Alwwex/Cyklopo-ta-/docs/img/displej-dash-noc.png

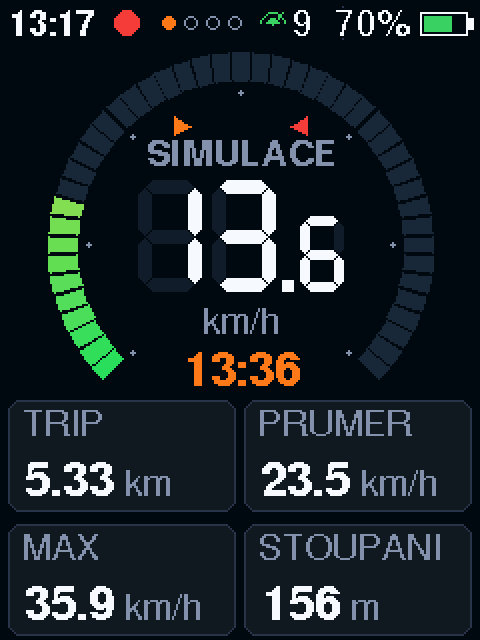
docs/img/displej-dash-noc.png
