Alwwex/Cyklopo-ta-/docs/img/displej-dash-retro.png

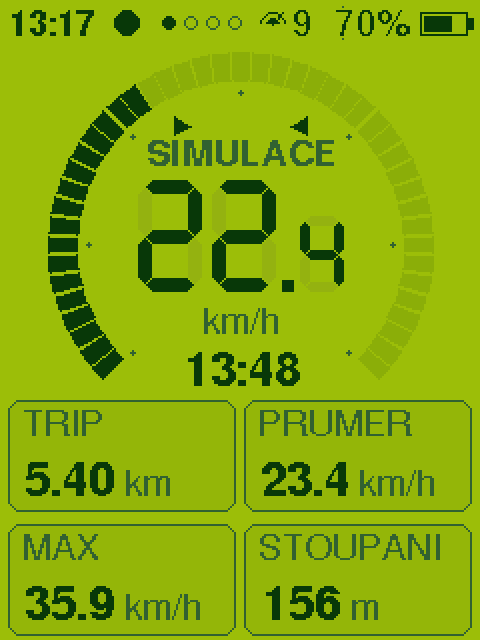
docs/img/displej-dash-retro.png
