Alwwex/Cyklopo-ta-/docs/img/displej-mapa-retro.png

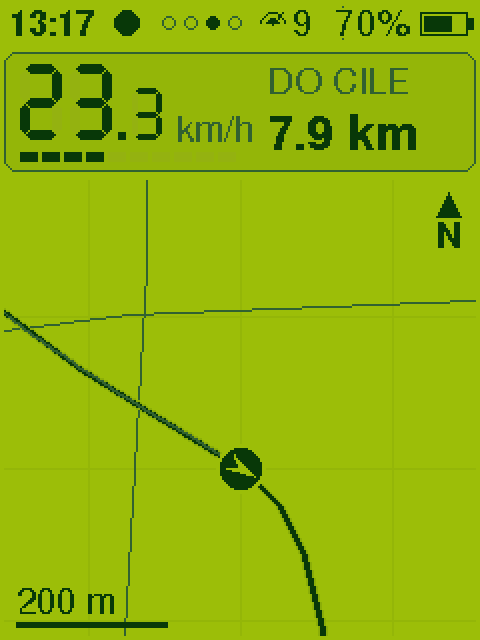
docs/img/displej-mapa-retro.png
