Alwwex/Cyklopo-ta-/docs/img/displej-souhrn.png

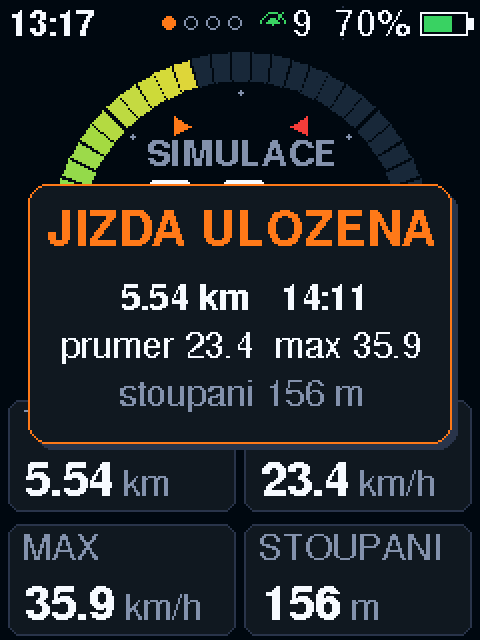
docs/img/displej-souhrn.png
