Alwwex/Cyklopo-ta-/hardware/enclosure/img/base_top.png

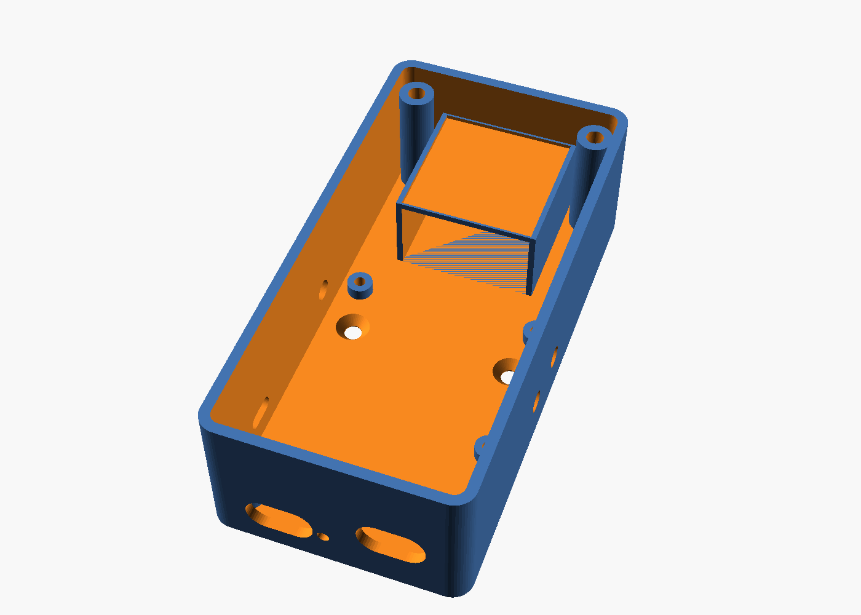
hardware/enclosure/img/base_top.png
