Alwwex/Cyklopo-ta-/hardware/enclosure/img/exploded.png

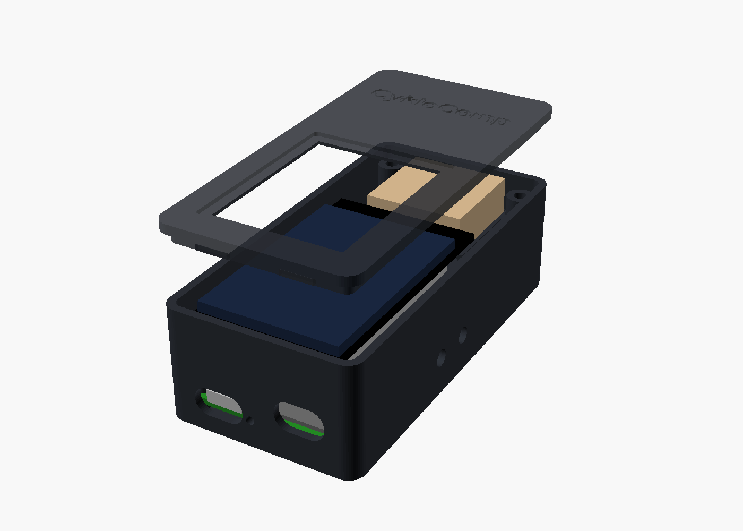
hardware/enclosure/img/exploded.png
