Alwwex/Cyklopo-ta-/hardware/enclosure/stl/lid.stl

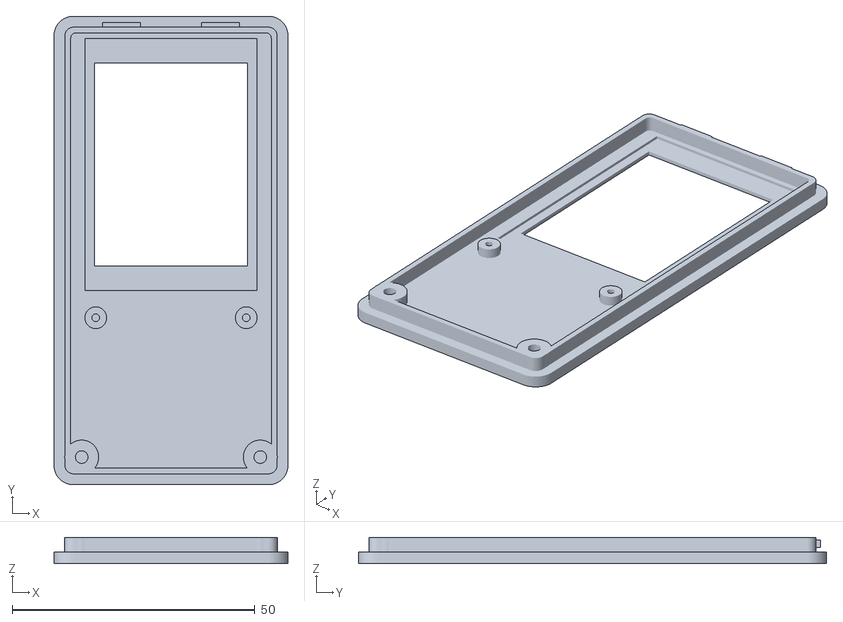
[picture p11: CAD file, 2026-10-15]
hardware/enclosure/stl/lid.stl
48.2 x 96.5 x 5.40
