Alwwex/Cyklopo-ta-/hardware/pcb/build_rucni/CykloPCB_v1_rucni.step

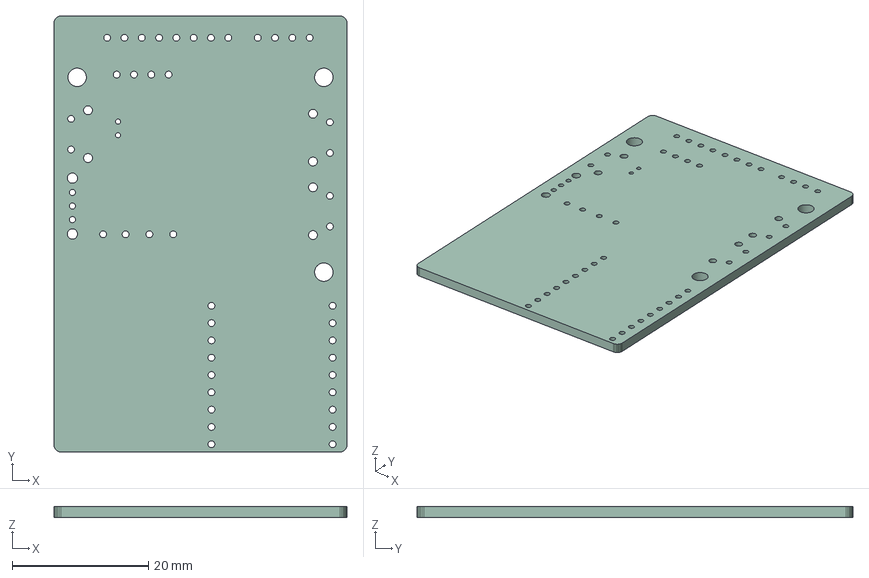
[picture p12: CAD file, 2026-10-15]
hardware/pcb/build_rucni/CykloPCB_v1_rucni.step
43.0 x 64.0 x 1.60 mm
