Alwwex/Cyklopo-ta-/hardware/enclosure/stl/tray.stl

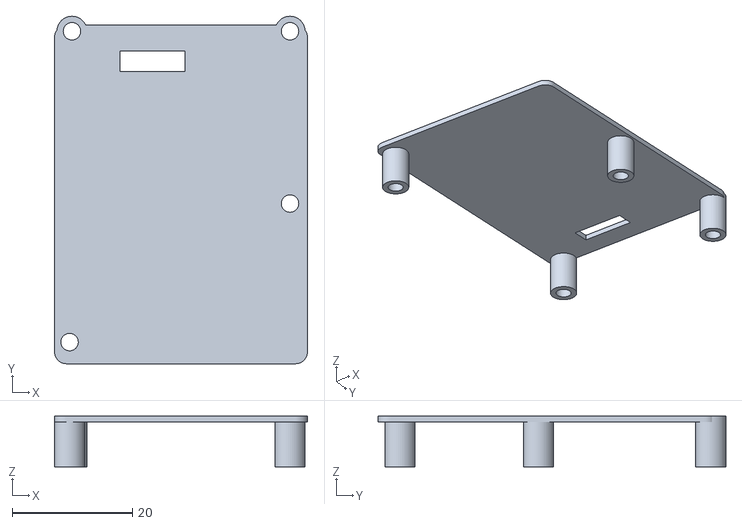
[picture p13: CAD file, 2026-10-15]
hardware/enclosure/stl/tray.stl
42.0 x 57.7 x 8.40
