Alwwex/Cyklopo-ta-/hardware/enclosure/stl/garmin_test.stl

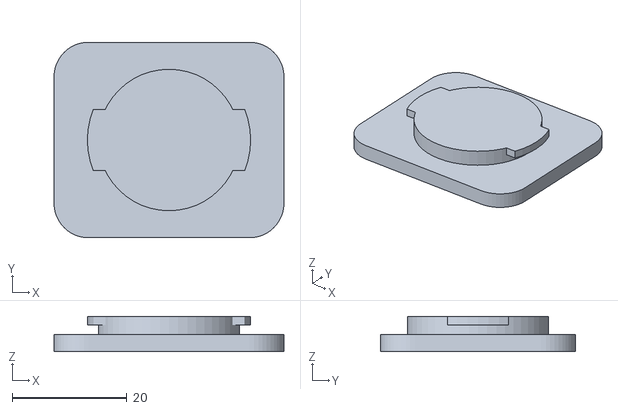
[picture p14: CAD file, 2026-10-15]
hardware/enclosure/stl/garmin_test.stl
40.0 x 34.0 x 6.10
