Alwwex/Cyklopo-ta-/hardware/enclosure/stl/base.stl

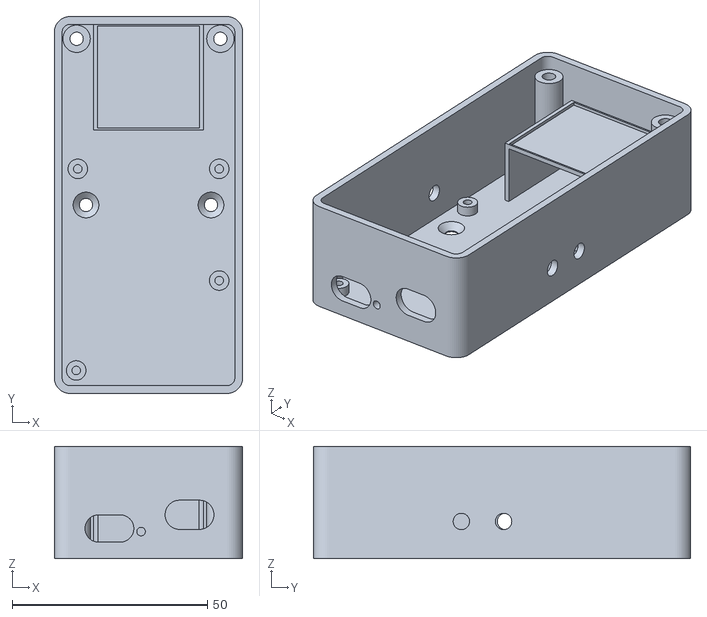
[picture p15: CAD file, 2026-10-15]
hardware/enclosure/stl/base.stl
48.2 x 96.5 x 28.7
