Alwwex/Cyklopo-ta-/hardware/pcb/generate_pcb.py

#!/usr/bin/env python3
"""
CykloPCB v1 - nosna deska pro CykloComp (ESP32-C3-Zero + displej + GPS + Li-Po).

Tento skript je "zdrojak" plosneho spoje: z popisu soucastek a spoju nize
vytvori KiCad desku, rozmisti soucastky, nechá cesty natahnout autorouterem
Freerouting, prida rozliti zeme, zkontroluje DRC a vyexportuje podklady
pro vyrobu u JLCPCB (Gerber + vrtani + BOM + CPL pro osazeni).

Pozadavky (Linux):  KiCad 7 (python modul pcbnew + kicad-cli), Java 17+,
                    freerouting-1.9.0.jar, xvfb-run
Spusteni:           python3 generate_pcb.py  [--freerouting /cesta/freerouting.jar]
"""
import argparse
import csv
import math
import os
import re
import shutil
import subprocess
import sys
import zipfile

import pcbnew

HERE = os.path.dirname(os.path.abspath(__file__))
FP_LIB = '/usr/share/kicad/footprints'
NAME = 'CykloPCB_v1'

W, H = 43.0, 64.0          # rozmer desky [mm]
VIA_D, VIA_DRILL = 0.7, 0.3
USB_SLOT_W = 0.7
SILK_W = 0.16
SILK_HOLE_CLR = 0.25
SILK_PAD_CLR = 0.2
SILK_MIN_SEG = 0.20
SILK_EDGE_CLR = 0.2        # potisk konci aspon 0.2 mm od hrany desky
CORNER = 1.0               # zaobleni rohu

mm = pcbnew.FromMM

# ---------------------------------------------------------------------------
# NAPAJENI (cela cesta):
#   USB-C (J1) --VBUS--> TP4056 (U1, nabijeni 600 mA) --BAT+--> Li-Po (J4)
#   VBUS --D3 Schottky--> SYS ;  BAT+ --Q1 P-MOSFET--> SYS   ("load sharing":
#   pri pripojenem USB jede system z USB a baterie se jen nabiji, jinak z baterie)
#   SYS --SW1 vypinac--> VSW --U2 LDO 3.3 V--> 3V3 (ESP, displej, GPS)
#   VSW --R7/R8 delic 1:2--> GPIO0 (mereni baterie / detekce USB)
#   3V3 --Q2--> GPS_VCC (GPIO10 vypina GPS ve spanku)
#   3V3 --Q3--> BLK displeje (GPIO7 = PWM jas)
# Baterie MUSI mit vlastni ochranny obvod (PCM) - u clanku 103450 standard.
# ---------------------------------------------------------------------------

# LCSC cisla pro osazeni u JLCPCB (pred objednavkou zkontroluj skladem)
LCSC = {
    'TP4056': 'C16581', 'AO3401A': 'C15127', 'SS34': 'C8678', 'AP2112K-3.3': 'C51118',
    'USB-C 16P': 'C165948', '10uF': 'C15850', '100nF': 'C14663', '5.1k': 'C23186',
    '2k': 'C22975', '1k': 'C21190', '100k': 'C25803', '10k': 'C25804',
    'LED red': 'C2286', 'LED green': 'C7429914',
}

R0603 = ('Resistor_SMD', 'R_0603_1608Metric')
C0603 = ('Capacitor_SMD', 'C_0603_1608Metric')
C0805 = ('Capacitor_SMD', 'C_0805_2012Metric')
LED0603 = ('LED_SMD', 'LED_0603_1608Metric')
SOT23 = ('Package_TO_SOT_SMD', 'SOT-23')

# (ref, (lib, footprint) | 'C3ZERO', value, x, y, rot, {pad: net}, osazuje JLC)
PARTS = [
    # --- USB-C nabijeni ---
    ('J1', ('Connector_USB', 'USB_C_Receptacle_HRO_TYPE-C-31-M-12'), 'USB-C 16P', 11.5, 60.65, 0,
     {'A1': 'GND', 'B1': 'GND', 'A12': 'GND', 'B12': 'GND', 'S1': 'GND',
      'A4': 'VBUS', 'B4': 'VBUS', 'A9': 'VBUS', 'B9': 'VBUS', 'A5': 'CC1', 'B5': 'CC2'}, True),
    ('R1', R0603, '5.1k', 8.0, 52.6, 90, {'1': 'CC1', '2': 'GND'}, True),
    ('R2', R0603, '5.1k', 15.6, 52.6, 90, {'1': 'CC2', '2': 'GND'}, True),
    ('C1', C0805, '10uF', 18.6, 50.6, 90, {'1': 'VBUS', '2': 'GND'}, True),
    # --- nabijecka TP4056 ---
    ('U1', ('Package_SO', 'SOIC-8-1EP_3.9x4.9mm_P1.27mm_EP2.41x3.3mm'), 'TP4056', 12.0, 46.6, 0,
     {'1': 'GND', '2': 'PROG', '3': 'GND', '4': 'VBUS', '5': 'BAT+', '6': 'STDBY', '7': 'CHRG', '8': 'VBUS', '9': 'GND'}, True),
    ('R3', R0603, '2k', 7.3, 43.0, 0, {'1': 'PROG', '2': 'GND'}, True),
    ('C2', C0805, '10uF', 12.0, 41.4, 0, {'1': 'BAT+', '2': 'GND'}, True),
    ('R4', R0603, '1k', 18.5, 54.2, 0, {'1': 'VBUS', '2': 'LED_R'}, True),
    ('R5', R0603, '1k', 18.5, 56.0, 0, {'1': 'VBUS', '2': 'LED_G'}, True),
    ('D1', LED0603, 'LED red', 18.5, 58.0, 180, {'1': 'CHRG', '2': 'LED_R'}, True),
    ('D2', LED0603, 'LED green', 18.5, 60.0, 180, {'1': 'STDBY', '2': 'LED_G'}, True),
    # --- load sharing + vypinac + LDO ---
    ('D3', ('Diode_SMD', 'D_SMA'), 'SS34', 12.6, 37.6, 0, {'1': 'SYS', '2': 'VBUS'}, True),
    ('Q1', SOT23, 'AO3401A', 18.3, 38.6, 0, {'1': 'VBUS', '2': 'SYS', '3': 'BAT+'}, True),
    ('R6', R0603, '100k', 18.3, 42.2, 0, {'1': 'VBUS', '2': 'GND'}, True),
    ('C3', C0805, '10uF', 18.3, 35.4, 0, {'1': 'SYS', '2': 'GND'}, True),
    ('SW1', ('Button_Switch_THT', 'SW_Slide_SPDT_Angled_CK_OS102011MA1Q'), 'ON/OFF', 2.7, 45.0, -90,
     {'1': 'SYS', '2': 'VSW', '3': ''}, False),
    ('U2', ('Package_TO_SOT_SMD', 'SOT-23-5'), 'AP2112K-3.3', 9.6, 31.6, 0,
     {'1': 'VSW', '2': 'GND', '3': 'VSW', '4': '', '5': '3V3'}, True),
    ('C4', C0805, '10uF', 5.0, 30.0, 90, {'1': 'VSW', '2': 'GND'}, True),
    ('C6', C0805, '10uF', 14.4, 31.6, 90, {'1': '3V3', '2': 'GND'}, True),
    ('C7', C0603, '100nF', 14.4, 28.2, 0, {'1': '3V3', '2': 'GND'}, True),
    # --- mereni baterie (delic 1:2 -> GPIO0) ---
    ('R7', R0603, '100k', 26.0, 38.4, 0, {'1': 'VSW', '2': 'BAT_SENSE'}, True),
    ('R8', R0603, '100k', 26.0, 36.6, 0, {'1': 'BAT_SENSE', '2': 'GND'}, True),
    ('C5', C0603, '100nF', 26.0, 34.8, 0, {'1': 'BAT_SENSE', '2': 'GND'}, True),
    # --- baterie ---
    ('J4', ('Connector_JST', 'JST_PH_S2B-PH-K_1x02_P2.00mm_Horizontal'), 'LiPo 3.7V', 9.0, 22.6, 90,
     {'1': 'BAT+', '2': 'GND'}, False),
    # --- ESP32-C3-Zero ---
    ('U3', 'C3ZERO', 'ESP32-C3-Zero', 32.0, 52.7, 180,
     {'1': '', '2': 'GND', '3': '3V3', '4': 'BAT_SENSE', '5': 'TFT_RST', '6': 'TFT_DC', '7': 'TFT_CS',
      '8': 'TFT_SCLK', '9': 'BTN1', '10': 'TFT_MOSI', '11': 'BL_PWM', '12': 'BTN2', '13': 'BTN3',
      '14': 'GPS_EN', '15': '', '16': '', '17': 'GPS_TXD', '18': 'GPS_RXD'}, False),
    # --- displej (ST7789, poradi pinu jako bezny 2.0"/2.4"/2.8" IPS modul) ---
    ('J2', ('Connector_PinHeader_2.54mm', 'PinHeader_1x08_P2.54mm_Vertical'), 'TFT', 7.8, 3.2, 90,
     {'1': 'GND', '2': '3V3', '3': 'TFT_SCLK', '4': 'TFT_MOSI', '5': 'TFT_RST', '6': 'TFT_DC', '7': 'TFT_CS', '8': 'TFT_BLK'}, False),
    ('Q3', SOT23, 'AO3401A', 22.0, 9.6, 90, {'1': 'BL_G', '2': '3V3', '3': 'TFT_BLK'}, True),
    ('R11', R0603, '100k', 25.2, 9.0, 90, {'1': '3V3', '2': 'BL_G'}, True),
    ('R12', R0603, '1k', 25.2, 12.6, 90, {'1': 'BL_G', '2': 'BL_PWM'}, True),
    # --- GPS ---
    ('J3', ('Connector_PinHeader_2.54mm', 'PinHeader_1x04_P2.54mm_Vertical'), 'GPS', 29.9, 3.2, 90,
     {'1': 'GPS_VCC', '2': 'GND', '3': 'GPS_TXD', '4': 'GPS_RXD'}, False),
    ('Q2', SOT23, 'AO3401A', 30.4, 9.6, 90, {'1': 'GPS_G', '2': '3V3', '3': 'GPS_VCC'}, True),
    ('R9', R0603, '100k', 33.6, 9.0, 90, {'1': '3V3', '2': 'GPS_G'}, True),
    ('R10', R0603, '1k', 33.6, 12.6, 90, {'1': 'GPS_G', '2': 'GPS_EN'}, True),
    ('C8', C0603, '100nF', 27.6, 9.0, 90, {'1': 'GPS_VCC', '2': 'GND'}, True),
    # --- tlacitka (boční, uhlova) + konektor pro externi vodotesna tlacitka ---
    ('SW2', ('Button_Switch_THT', 'SW_Tactile_SPST_Angled_PTS645Vx31-2LFS'), 'MODE', 2.5, 19.6, 90,
     {'1': 'BTN1', '2': 'GND'}, False),
    ('SW3', ('Button_Switch_THT', 'SW_Tactile_SPST_Angled_PTS645Vx31-2LFS'), 'START', 40.5, 15.6, -90,
     {'1': 'BTN2', '2': 'GND'}, False),
    ('SW4', ('Button_Switch_THT', 'SW_Tactile_SPST_Angled_PTS645Vx31-2LFS'), 'PAUSE', 40.5, 26.4, -90,
     {'1': 'BTN3', '2': 'GND'}, False),
    ('R13', R0603, '100k', 19.0, 23.0, 0, {'1': '3V3', '2': 'BTN1'}, True),
    ('R14', R0603, '10k', 30.0, 21.0, 0, {'1': '3V3', '2': 'BTN2'}, True),
    ('J5', ('Connector_PinHeader_2.54mm', 'PinHeader_1x04_P2.54mm_Vertical'), 'BTN ext', 13.0, 14.0, 90,
     {'1': 'BTN1', '2': 'BTN2', '3': 'BTN3', '4': 'GND'}, False),
    # --- montazni otvory M2.5 ---
    ('H1', ('MountingHole', 'MountingHole_2.7mm_M2.5'), 'M2.5', 3.4, 9.0, 0, {}, False),
    ('H2', ('MountingHole', 'MountingHole_2.7mm_M2.5'), 'M2.5', 39.6, 9.0, 0, {}, False),
    ('H3', ('MountingHole', 'MountingHole_2.7mm_M2.5'), 'M2.5', 3.0, 60.6, 0, {}, False),
    ('H4', ('MountingHole', 'MountingHole_2.7mm_M2.5'), 'M2.5', 39.6, 37.6, 0, {}, False),
]

POWER_NETS = ['GND', 'VBUS', 'BAT+', 'BNEG', 'SYS', 'VSW', '3V3', 'GPS_VCC', 'TFT_BLK']

# popisky pinu ESP32-C3-Zero (pady 1-9 vlevo od USB dolu, 10-18 vpravo zdola nahoru, USB nahore)
C3_LABELS = ['5V', 'GND', '3V3', 'GP0', 'GP1', 'GP2', 'GP3', 'GP4', 'GP5',
             'GP6', 'GP7', 'GP8', 'GP9', 'GP10', 'GP18', 'GP19', 'GP20', 'GP21']

SILK = [  # (text, x, y, size, rot)
    ('CykloPCB v1', 21.5, 27.4, 1.2, 0),
    ('CykloComp', 21.5, 29.4, 0.9, 0),
    ('TFT', 3.6, 3.2, 1.0, 0),
    ('GPS', 27.75, 3.2, 0.8, 90),
    ('+', 7.3, 22.6, 0.9, 0),
    ('-', 7.3, 20.25, 0.9, 0),
    ('ON', 5.2, 40.6, 1.0, 0),
    ('MODE', 3.4, 25.0, 0.8, 0),
    ('START', 36.2, 12.0, 0.8, 0),
    ('PAUZA', 34.5, 23.4, 0.8, 0),
    ('NABIJENI', 11.5, 50.3, 0.8, 0),
    ('ESP USB', 32.0, 39.6, 0.8, 0),
]
# popisky pinu konektoru (pod kazdym pinem)
for i, t in enumerate(['G', 'V', 'CK', 'DA', 'RS', 'DC', 'CS', 'BL']):
    SILK.append((t, 7.8 + i * 2.54, 5.6, 0.8, 0))
for i, t in enumerate(['V', 'G', 'TX', 'RX']):
    SILK.append((t, 29.9 + i * 2.54, 5.6, 0.8, 0))
for i, t in enumerate(['M', 'S', 'P', 'G']):
    SILK.append((t, 13.0 + i * 2.54, 16.7, 0.8, 0))


# ===========================================================================
# VARIANTA "RUCNI" (--variant hand): objednas jen holy plosny spoj a vse
# zapajis sam. Vetsi soucastky (1206, SOT-223, SMA, THT) a misto USB-C + TP4056
# na desce se pouzije hotovy modul "TP4056 Type-C" s ochranou (DW01 + 8205A).
# Modul se nalepi oboustrannou penovou paskou (~1 mm) na desku, USB-C k zadni
# hrane, a 4 dratky vedou z jeho plosek na radu plosek za jeho koncem:
#   modul IN+  -> IN+  (VBUS: D3 load sharing, gate Q1, detekce USB)
#   modul OUT+ -> OUT+ (BAT+; na modulu je OUT+ = B+)
#   modul B-   -> B-   (BNEG: minus baterie z J4 - NIKDY ne primo na GND,
#                       jinak se obejde ochrana modulu)
#   modul OUT- -> OUT- (GND)        modul IN- se nezapojuje
# Modul bez ochrany (jen IN+/IN-/B+/B-): IN+ -> IN+, B+ -> OUT+, B- -> OUT-
# a propojit pajeci mustek JP1 (B- = GND).
# Zbytek zapojeni (vypinac, LDO, mereni baterie, spinani GPS a podsviceni,
# tlacitka, ESP) je stejny jako ve variante pro JLC -> stejny firmware (BOARD_PROFILE 1).
# ===========================================================================
NAME_HAND = 'CykloPCB_v1_rucni'
R1206 = ('Resistor_SMD', 'R_1206_3216Metric_Pad1.30x1.75mm_HandSolder')
C1206 = ('Capacitor_SMD', 'C_1206_3216Metric_Pad1.33x1.80mm_HandSolder')
SOT23H = ('Package_TO_SOT_SMD', 'SOT-23_Handsoldering')
SMAH = ('Diode_SMD', 'D_SMA_Handsoldering')
LDO_FP = ('Package_TO_SOT_SMD', 'SOT-223-3_TabPin2')
LDO_PART = 'MCP1825S-3302E/DB'
LDO_PINS = {'1': 'VSW', '2': 'GND', '3': '3V3'}          # SOT-223: 1 VIN, 2 GND (+ chladici plocha), 3 VOUT

# misto pro modul TP4056 Type-C (sirka x delka od hrany desky): pokryje bezne moduly
# 25-28.4 x 17.2-17.8 mm + presah USB-C 1-1.4 mm + vule na nalepeni
# (strana "+" modulu = IN+/B+/OUT+ je pri pohledu shora s USB-C dole VLEVO)
MOD_W, MOD_L = 19.0, 30.3
MOD_PAD_D, MOD_PAD_DRILL = 2.2, 1.0
MOD_PADS = [  # (cislo, x, y, popisek, sit) od stredu mista pro modul; rada plosek za jeho koncem
    ('1', -4.3, -MOD_L / 2 - 1.65, 'IN+', 'VBUS'),
    ('2', -1.0, -MOD_L / 2 - 1.65, 'OUT+', 'BAT+'),
    ('3', 2.5, -MOD_L / 2 - 1.65, 'B-', 'BNEG'),
    ('4', 6.0, -MOD_L / 2 - 1.65, 'OUT-', 'GND'),
]

PARTS_HAND = [
    # --- nabijeci modul TP4056 Type-C (uz ho mas) ---
    ('A1', 'TP4056MOD', 'TP4056 USB-C modul', 11.5, H - MOD_L / 2, 0, {m[0]: m[4] for m in MOD_PADS}, False),
    ('J4', ('Connector_JST', 'JST_PH_S2B-PH-K_1x02_P2.00mm_Horizontal'), 'LiPo 3.7V', 9.4, 17.5, 90,
     {'1': 'BAT+', '2': 'BNEG'}, False),
    ('JP1', ('Jumper', 'SolderJumper-2_P1.3mm_Open_Pad1.0x1.5mm'), 'B- = GND', 20.7, 32.0, 90,
     {'1': 'BNEG', '2': 'GND'}, False),
    # --- load sharing + vypinac + LDO ---
    ('D3', SMAH, 'SS34', 11.9, 22.2, 0, {'1': 'SYS', '2': 'VBUS'}, False),
    ('Q1', SOT23H, 'AO3401A', 19.6, 22.2, 0, {'1': 'VBUS', '2': 'SYS', '3': 'BAT+'}, False),
    ('R6', R1206, '100k', 10.5, 26.65, 0, {'1': 'VBUS', '2': 'GND'}, False),
    ('C3', C1206, '10uF', 16.0, 26.65, 0, {'1': 'SYS', '2': 'GND'}, False),
    ('SW1', ('Button_Switch_THT', 'SW_Slide_SPDT_Angled_CK_OS102011MA1Q'), 'ON/OFF', 2.7, 25.9, -90,
     {'1': 'SYS', '2': 'VSW', '3': ''}, False),
    ('U2', LDO_FP, LDO_PART, 27.5, 23.9, 0, LDO_PINS, False),
    ('C4', C1206, '10uF', 25.0, 18.3, 0, {'1': 'VSW', '2': 'GND'}, False),
    ('C6', C1206, '10uF', 25.0, 29.4, 0, {'1': '3V3', '2': 'GND'}, False),
    ('C7', C1206, '100nF', 30.6, 29.4, 0, {'1': '3V3', '2': 'GND'}, False),
    # --- mereni baterie (delic 1:2 -> GPIO0) ---
    ('R7', R1206, '100k', 25.0, 32.9, 0, {'1': 'VSW', '2': 'BAT_SENSE'}, False),
    ('R8', R1206, '100k', 25.0, 35.9, 0, {'1': 'BAT_SENSE', '2': 'GND'}, False),
    ('C5', C1206, '100nF', 30.0, 34.4, 90, {'1': 'BAT_SENSE', '2': 'GND'}, False),
    # --- ESP32-C3-Zero ---
    ('U3', 'C3ZERO', 'ESP32-C3-Zero', 32.0, 52.7, 180,
     {'1': '', '2': 'GND', '3': '3V3', '4': 'BAT_SENSE', '5': 'TFT_RST', '6': 'TFT_DC', '7': 'TFT_CS',
      '8': 'TFT_SCLK', '9': 'BTN1', '10': 'TFT_MOSI', '11': 'BL_PWM', '12': 'BTN2', '13': 'BTN3',
      '14': 'GPS_EN', '15': '', '16': '', '17': 'GPS_TXD', '18': 'GPS_RXD'}, False),
    # --- displej ---
    ('J2', ('Connector_PinHeader_2.54mm', 'PinHeader_1x08_P2.54mm_Vertical'), 'TFT', 7.8, 3.2, 90,
     {'1': 'GND', '2': '3V3', '3': 'TFT_SCLK', '4': 'TFT_MOSI', '5': 'TFT_RST', '6': 'TFT_DC', '7': 'TFT_CS', '8': 'TFT_BLK'}, False),
    ('Q3', SOT23H, 'AO3401A', 21.4, 9.2, 90, {'1': 'BL_G', '2': '3V3', '3': 'TFT_BLK'}, False),
    ('R11', R1206, '100k', 25.0, 9.2, 90, {'1': '3V3', '2': 'BL_G'}, False),
    ('R12', R1206, '1k', 28.0, 9.2, 90, {'1': 'BL_G', '2': 'BL_PWM'}, False),
    # --- GPS ---
    ('J3', ('Connector_PinHeader_2.54mm', 'PinHeader_1x04_P2.54mm_Vertical'), 'GPS', 29.9, 3.2, 90,
     {'1': 'GPS_VCC', '2': 'GND', '3': 'GPS_TXD', '4': 'GPS_RXD'}, False),
    ('Q2', SOT23H, 'AO3401A', 31.6, 9.2, 90, {'1': 'GPS_G', '2': '3V3', '3': 'GPS_VCC'}, False),
    ('R9', R1206, '100k', 25.0, 15.1, 0, {'1': '3V3', '2': 'GPS_G'}, False),
    ('R10', R1206, '1k', 30.5, 15.1, 0, {'1': 'GPS_G', '2': 'GPS_EN'}, False),
    ('C8', C1206, '100nF', 35.0, 9.2, 90, {'1': 'GPS_VCC', '2': 'GND'}, False),
    # --- tlacitka ---
    ('SW2', ('Button_Switch_THT', 'SW_Tactile_SPST_Angled_PTS645Vx31-2LFS'), 'MODE', 2.5, 19.6, 90,
     {'1': 'BTN1', '2': 'GND'}, False),
    ('SW3', ('Button_Switch_THT', 'SW_Tactile_SPST_Angled_PTS645Vx31-2LFS'), 'START', 40.5, 15.6, -90,
     {'1': 'BTN2', '2': 'GND'}, False),
    ('SW4', ('Button_Switch_THT', 'SW_Tactile_SPST_Angled_PTS645Vx31-2LFS'), 'PAUSE', 40.5, 26.4, -90,
     {'1': 'BTN3', '2': 'GND'}, False),
    ('R13', R1206, '100k', 18.0, 16.0, 90, {'1': '3V3', '2': 'BTN1'}, False),
    ('R14', R1206, '10k', 30.5, 18.3, 0, {'1': '3V3', '2': 'BTN2'}, False),
    ('J5', ('Connector_PinHeader_2.54mm', 'PinHeader_1x04_P2.54mm_Vertical'), 'BTN ext', 9.2, 8.6, 90,
     {'1': 'BTN1', '2': 'BTN2', '3': 'BTN3', '4': 'GND'}, False),
    # --- montazni otvory M2.5 (H3 vlevo dole odpada - je tam modul) ---
    ('H1', ('MountingHole', 'MountingHole_2.7mm_M2.5'), 'M2.5', 3.4, 9.0, 0, {}, False),
    ('H2', ('MountingHole', 'MountingHole_2.7mm_M2.5'), 'M2.5', 39.6, 9.0, 0, {}, False),
    ('H4', ('MountingHole', 'MountingHole_2.7mm_M2.5'), 'M2.5', 39.6, 37.6, 0, {}, False),
]

SILK_HAND = [
    ('CykloPCB v1 R', 11.5, 61.6, 1.0, 0),
    ('TFT', 3.6, 3.2, 1.0, 0),
    ('GPS', 27.6, 2.8, 0.8, 90),
    ('ON', 6.4, 24.4, 0.8, 90),
    ('K', 6.5, 22.2, 0.8, 0),
    ('MODE', 6.6, 12.4, 0.8, 0),
    ('START', 36.2, 12.0, 0.8, 0),
    ('PAUZA', 33.8, 32.4, 0.8, 0),
    ('USB-C ESP', 32.0, 62.4, 0.8, 0),
    ('+', 7.9, 17.5, 0.9, 0),
    ('B-', 7.5, 15.5, 0.8, 0),
]
for i, t in enumerate(['G', 'V', 'CK', 'DA', 'RS', 'DC', 'CS', 'BL']):
    SILK_HAND.append((t, 7.8 + i * 2.54, 5.6, 0.8, 0))
for i, t in enumerate(['V', 'G', 'TX', 'RX']):
    SILK_HAND.append((t, 29.9 + i * 2.54, 5.6, 0.8, 0))
for i, t in enumerate(['M', 'S', 'P', 'G']):
    SILK_HAND.append((t, 9.2 + i * 2.54, 11.3, 0.8, 0))

# popisky soucastek (R7, C3...) na potisku: {ref: (x, y, rot)}; ktere tu nejsou, umisti se samy
REF_POS_HAND = {'C8': (36.7, 9.2, 90), 'C7': (34.6, 29.4, 0), 'D3': (11.9, 24.6, 0),
                'R6': (10.5, 28.45, 0), 'C3': (16.0, 28.45, 0), 'Q1': (19.6, 19.7, 0), 'JP1': (21.0, 29.6, 0),
                'C6': (25.0, 31.15, 0), 'C5': (30.0, 37.6, 0)}
REF_SIZE_HAND = 0.8
REF_MISSING = []

# seznam soucastek k nakupu: sjednoceni nazvu + kde koupit (kody over pred objednavkou)
BOM_VALUE_HAND = {
    'MODE': 'Tlacitko 6x6 uhlove', 'START': 'Tlacitko 6x6 uhlove', 'PAUSE': 'Tlacitko 6x6 uhlove',
    'TFT': 'Kolikova lista 1x8', 'GPS': 'Kolikova lista 1x4', 'BTN ext': 'Kolikova lista 1x4 (volitelne)',
}
SHOP_HAND = {
    'TP4056 USB-C modul': 'uz mas; nejlepe verze s ochranou (6 plosek IN+ IN- B+ B- OUT+ OUT-), max. 19 x 30 mm vc. USB-C',
    'LiPo 3.7V': 'JST PH 2.0 mm 2pin uhlovy (S2B-PH-K-S) + protikus PHR-2 nebo hotovy kabel PH2.0; lze i bez nej',
    'B- = GND': 'nic nekupovat - pajeci mustek, spojit JEN pro modul bez ochrany',
    'SS34': 'Schottky 40 V 3 A v pouzdru SMA, napr. SK34A (TME: SK34A-LTP); jde i SS24A (SMA). SS34 v SMB/SMC je vetsi!',
    'AO3401A': 'P-MOSFET SOT-23, TME: AO3401A; nahrada IRLML6401 (stejne vyvody G-S-D). Kup 2-3 navic',
    'MCP1825S-3302E/DB': 'LDO 3.3 V 500 mA SOT-223 (TME, Mouser). NE AMS1117/LD1117 - maji jine poradi vyvodu!',
    '100k': 'rezistor 1206 1 % (napr. Yageo RC1206FR-07100KL) nebo sada 1206',
    '10k': 'rezistor 1206 1 % (napr. Yageo RC1206FR-0710KL)',
    '1k': 'rezistor 1206 1 % (napr. Yageo RC1206FR-071KL)',
    '10uF': 'keramicky kondenzator 1206 10 uF 25 V X5R/X7R (napr. Samsung CL31A106KAHNNNE)',
    '100nF': 'keramicky kondenzator 1206 100 nF 50 V X7R (napr. Samsung CL31B104KBCNNNC)',
    'ON/OFF': 'posuvny prepinac uhlovy C&K OS102011MA1QN1 (TME)',
    'Tlacitko 6x6 uhlove': 'C&K PTS645VL31-2 LFS (TME: PTS645VL312LFS); levna z AliExpressu mivaji jinou roztec',
    'ESP32-C3-Zero': 'uz mas (+ 2x lista 1x9, pokud nebyla pripajena)',
    'Kolikova lista 1x8': 'lista 1x40 2,54 mm (GME, TME) - nalamat; nebo zdirkova, kdyz ma jit displej odpojit',
    'Kolikova lista 1x4': 'ze stejne listy 1x40',
    'Kolikova lista 1x4 (volitelne)': 'jen pro externi vodotesna tlacitka',
}

VARIANT = 'jlc'


# ---------------------------------------------------------------------------
def load_fp(lib, name):
    fp = pcbnew.FootprintLoad(f'{FP_LIB}/{lib}.pretty', name)
    if fp is None:
        sys.exit(f'Footprint {lib}:{name} nenalezen')
    return fp


def make_c3zero(board):
    """Waveshare ESP32-C3-Zero (18 x 23.5 mm). Pady 2.54 mm, rady +-8.89 mm.
    Pady jsou protazene (2.6 mm), takze jde modul zapajet pres kolíkovou listu
    i naplocho za "castellated" pulotvory na okraji."""
    fp = pcbnew.FOOTPRINT(board)
    fp.SetFPID(pcbnew.LIB_ID('CykloPCB', 'ESP32-C3-Zero'))
    for i in range(18):
        if i < 9:
            x, y = -8.89, -10.16 + i * 2.54
        else:
            x, y = 8.89, 10.16 - (i - 9) * 2.54
        p = pcbnew.PAD(fp)
        p.SetNumber(str(i + 1))
        p.SetAttribute(pcbnew.PAD_ATTRIB_PTH)
        p.SetShape(pcbnew.PAD_SHAPE_RECT if i == 0 else pcbnew.PAD_SHAPE_OVAL)
        p.SetSize(pcbnew.VECTOR2I(mm(2.6), mm(1.6)))
        p.SetDrillSize(pcbnew.VECTOR2I(mm(1.0), mm(1.0)))
        p.SetLayerSet(p.PTHMask())
        fp.Add(p)
        p.SetPos0(pcbnew.VECTOR2I(mm(x), mm(y)))
        p.SetPosition(pcbnew.VECTOR2I(mm(x), mm(y)))
        t = pcbnew.FP_TEXT(fp)
        t.SetText(C3_LABELS[i])
        t.SetLayer(pcbnew.F_SilkS)
        t.SetTextSize(pcbnew.VECTOR2I(mm(0.8), mm(0.8)))
        t.SetTextThickness(mm(SILK_W))
        t.SetPosition(pcbnew.VECTOR2I(mm(x + (3.1 if i < 9 else -3.1)), mm(y)))
        fp.Add(t)
    # obrys modulu + USB
    def line(layer, x1, y1, x2, y2, w=0.12):
        s = pcbnew.FP_SHAPE(fp)
        s.SetShape(pcbnew.SHAPE_T_SEGMENT)
        s.SetLayer(layer)
        fp.Add(s)
        s.SetStart0(pcbnew.VECTOR2I(mm(x1), mm(y1)))
        s.SetEnd0(pcbnew.VECTOR2I(mm(x2), mm(y2)))
        s.SetDrawCoord()
        s.SetWidth(mm(w))
    for layer, d in ((pcbnew.F_Fab, 0), (pcbnew.F_CrtYd, 0.25)):
        x0, y0, x1, y1 = -9 - d, -11.75 - d, 9 + d, 11.75 + d
        line(layer, x0, y0, x1, y0, 0.05); line(layer, x1, y0, x1, y1, 0.05)
        line(layer, x1, y1, x0, y1, 0.05); line(layer, x0, y1, x0, y0, 0.05)
    return fp


def make_tp4056_module(board):
    """Misto pro nabijeci modul TP4056 Type-C (nalepi se na desku) + plosky pro dratky.
    Pod modulem nesmi byt zadna soucastka (courtyard = obrys modulu)."""
    fp = pcbnew.FOOTPRINT(board)
    fp.SetFPID(pcbnew.LIB_ID('CykloPCB', 'TP4056_TypeC_module_wired'))
    for num, x, y, _lab, _net in MOD_PADS:
        p = pcbnew.PAD(fp)
        p.SetNumber(num)
        p.SetAttribute(pcbnew.PAD_ATTRIB_PTH)
        p.SetShape(pcbnew.PAD_SHAPE_RECT if num == '1' else pcbnew.PAD_SHAPE_CIRCLE)
        p.SetSize(pcbnew.VECTOR2I(mm(MOD_PAD_D), mm(MOD_PAD_D)))
        p.SetDrillSize(pcbnew.VECTOR2I(mm(MOD_PAD_DRILL), mm(MOD_PAD_DRILL)))
        p.SetLayerSet(p.PTHMask())
        fp.Add(p)
        p.SetPos0(pcbnew.VECTOR2I(mm(x), mm(y)))
        p.SetPosition(pcbnew.VECTOR2I(mm(x), mm(y)))

    def line(layer, x1, y1, x2, y2, w):
        s = pcbnew.FP_SHAPE(fp)
        s.SetShape(pcbnew.SHAPE_T_SEGMENT)
        s.SetLayer(layer)
        fp.Add(s)
        s.SetStart0(pcbnew.VECTOR2I(mm(x1), mm(y1)))
        s.SetEnd0(pcbnew.VECTOR2I(mm(x2), mm(y2)))
        s.SetDrawCoord()
        s.SetWidth(mm(w))
    hw, hl = MOD_W / 2, MOD_L / 2
    for layer, d, w in ((pcbnew.F_Fab, 0, 0.1), (pcbnew.F_SilkS, -0.3, SILK_W)):
        x0, y0, x1, y1 = -hw - d, -hl - d, hw + d, hl + d
        if layer == pcbnew.F_SilkS:      # carkovany obrys = sem prijde modul
            for (ax, ay, bx, by) in ((x0, y0, x1, y0), (x1, y0, x1, y1), (x0, y1, x0, y0)):
                L = math.hypot(bx - ax, by - ay)
                n = int(L // 2.0)
                for k in range(n):
                    t0, t1 = k / n, (k + 0.55) / n
                    line(layer, ax + (bx - ax) * t0, ay + (by - ay) * t0, ax + (bx - ax) * t1, ay + (by - ay) * t1, w)
        else:
            line(layer, x0, y0, x1, y0, w); line(layer, x1, y0, x1, y1, w)
            line(layer, x1, y1, x0, y1, w); line(layer, x0, y1, x0, y0, w)
    # courtyard: uzavreny tvar L = misto modulu + rada plosek pro dratky (s popisky nad nimi)
    r = MOD_PAD_D / 2 + 0.25
    xs = [m[1] for m in MOD_PADS]
    py = MOD_PADS[0][2] - r - 1.5
    pts = [(-hw, hl), (-hw, -hl), (min(xs) - r, -hl), (min(xs) - r, py), (max(xs) + r, py),
           (max(xs) + r, -hl), (hw, -hl), (hw, hl)]
    for (ax, ay), (bx, by) in zip(pts, pts[1:] + pts[:1]):
        line(pcbnew.F_CrtYd, ax, ay, bx, by, 0.05)
    return fp


def text_bbox(text, x, y, size, rot):
    """priblizny obdelnik textu (stredove zarovnani) v mm"""
    w, h = len(text) * size * 0.9 + 0.2, size + 0.3
    if rot % 180 == 90:
        w, h = h, w
    return x - w / 2, y - h / 2, x + w / 2, y + h / 2


def auto_ref_labels(board, skip):
    """Popisky soucastek na potisk (pro rucni osazeni): nad / pod / vedle soucastky,
    tak aby se neprekryvaly s jinymi soucastkami, popisky ani otvory."""
    TM = pcbnew.ToMM
    S = REF_SIZE_HAND
    boxes = []
    for f in board.GetFootprints():
        for x0, y0, x1, y1 in courtyard_boxes(f):
            boxes.append((f.GetReference(), (TM(x0), TM(y0), TM(x1), TM(y1))))
    taken = [text_bbox(*t[:3], t[3], t[4]) for t in SILK]
    for d in board.GetDrawings():
        if isinstance(d, pcbnew.PCB_TEXT):
            bb = d.GetBoundingBox()
            taken.append((TM(bb.GetX()), TM(bb.GetY()), TM(bb.GetRight()), TM(bb.GetBottom())))

    def free(bb, own):
        if bb[0] < 0.6 or bb[1] < 0.6 or bb[2] > W - 0.6 or bb[3] > H - 0.6:
            return False
        for ref, b in boxes:
            if ref != own and bb[0] < b[2] and b[0] < bb[2] and bb[1] < b[3] and b[1] < bb[3]:
                return False
        for b in taken:
            if bb[0] < b[2] and b[0] < bb[2] and bb[1] < b[3] and b[1] < bb[3]:
                return False
        return True
    out, missing = [], []
    for ref, (x0, y0, x1, y1) in sorted(boxes):
        if ref in skip:
            continue
        cx, cy = (x0 + x1) / 2, (y0 + y1) / 2
        if ref in REF_POS_HAND:
            x, y, rot = REF_POS_HAND[ref]
            cand = [(x, y, rot)]
        else:
            g = 0.15 + S / 2 + 0.15
            cand = [(cx, y0 - g, 0), (cx, y1 + g, 0), (x1 + g + len(ref) * S * 0.45, cy, 0),
                    (x0 - g - len(ref) * S * 0.45, cy, 0), (x1 + g, cy, 90), (x0 - g, cy, 90)]
        for x, y, rot in cand:
            bb = text_bbox(ref, x, y, S, rot)
            if ref in REF_POS_HAND or free(bb, ref):
                add_text(board, ref, x, y, S, rot)
                taken.append(bb)
                out.append(ref)
                break
        else:
            missing.append(ref)
    if missing:
        print('  POZOR: popisek se nevesel:', ', '.join(missing), '(dopln REF_POS_HAND)')
    REF_MISSING[:] = missing
    return missing


def add_edge(board):
    def seg(x1, y1, x2, y2):
        s = pcbnew.PCB_SHAPE(board)
        s.SetShape(pcbnew.SHAPE_T_SEGMENT)
        s.SetLayer(pcbnew.Edge_Cuts)
        s.SetStart(pcbnew.VECTOR2I(mm(x1), mm(y1)))
        s.SetEnd(pcbnew.VECTOR2I(mm(x2), mm(y2)))
        s.SetWidth(mm(0.1))
        board.Add(s)

    def arc(cx, cy, sx, sy, angle):
        a = pcbnew.PCB_SHAPE(board)
        a.SetShape(pcbnew.SHAPE_T_ARC)
        a.SetLayer(pcbnew.Edge_Cuts)
        a.SetCenter(pcbnew.VECTOR2I(mm(cx), mm(cy)))
        a.SetStart(pcbnew.VECTOR2I(mm(sx), mm(sy)))
        a.SetArcAngleAndEnd(pcbnew.EDA_ANGLE(angle, pcbnew.DEGREES_T), True)
        a.SetWidth(mm(0.1))
        board.Add(a)
    r = CORNER
    seg(r, 0, W - r, 0); seg(W, r, W, H - r); seg(W - r, H, r, H); seg(0, H - r, 0, r)
    arc(W - r, r, W - r, 0, 90); arc(W - r, H - r, W, H - r, 90)
    arc(r, H - r, r, H, 90); arc(r, r, 0, r, 90)


def add_text(board, text, x, y, size, rot=0, layer=pcbnew.F_SilkS):
    t = pcbnew.PCB_TEXT(board)
    t.SetText(text)
    t.SetLayer(layer)
    t.SetTextSize(pcbnew.VECTOR2I(mm(size), mm(size)))
    t.SetTextThickness(mm(max(SILK_W, size * 0.15)))
    t.SetPosition(pcbnew.VECTOR2I(mm(x), mm(y)))
    t.SetTextAngle(pcbnew.EDA_ANGLE(rot, pcbnew.DEGREES_T))
    board.Add(t)


def add_zone(board, net, layer, poly, rule_area=False):
    z = pcbnew.ZONE(board)
    z.SetLayer(layer)
    o = z.Outline()
    o.NewOutline()
    for x, y in poly:
        o.Append(mm(x), mm(y))
    if rule_area:
        z.SetIsRuleArea(True)
        z.SetDoNotAllowTracks(True)
        z.SetDoNotAllowVias(True)
        z.SetDoNotAllowCopperPour(True)
        z.SetDoNotAllowPads(False)
        z.SetDoNotAllowFootprints(False)
    else:
        z.SetNetCode(net.GetNetCode())
        z.SetLocalClearance(mm(0.3))
        z.SetMinThickness(mm(0.25))
        # rucni varianta: termalni mustky i u SMD plosek (GND ploska jde zapajet mikropajkou)
        z.SetPadConnection(pcbnew.ZONE_CONNECTION_THERMAL if VARIANT == 'hand'
                           else pcbnew.ZONE_CONNECTION_THT_THERMAL)
        z.SetThermalReliefGap(mm(0.4))
        z.SetThermalReliefSpokeWidth(mm(0.5))
        z.SetAssignedPriority(0)
    board.Add(z)
    return z


def courtyard_bbox(fp):
    xs, ys = [], []
    for g in fp.GraphicalItems():
        if g.GetLayer() == pcbnew.F_CrtYd:
            bb = g.GetBoundingBox()
            xs += [bb.GetX(), bb.GetRight()]
            ys += [bb.GetY(), bb.GetBottom()]
    if not xs:
        bb = fp.GetBoundingBox(False, False)
        return bb.GetX(), bb.GetY(), bb.GetRight(), bb.GetBottom()
    return min(xs), min(ys), max(xs), max(ys)


def courtyard_boxes(fp):
    """courtyard jako seznam obdelniku (modul TP4056 ma tvar L: misto modulu + rada plosek)"""
    if fp.GetFPID().GetLibItemName().wx_str() != 'TP4056_TypeC_module_wired':
        return [courtyard_bbox(fp)]
    c = fp.GetPosition()
    xs = [m[1] for m in MOD_PADS]
    r, py = MOD_PAD_D / 2 + 0.25, MOD_PADS[0][2]
    rects = [(-MOD_W / 2, -MOD_L / 2, MOD_W / 2, MOD_L / 2),
             (min(xs) - r, py - r - 1.5, max(xs) + r, -MOD_L / 2)]
    return [(c.x + mm(a), c.y + mm(b), c.x + mm(d), c.y + mm(e)) for a, b, d, e in rects]


def check_overlaps(board):
    fps = list(board.GetFootprints())
    boxes = {f.GetReference(): courtyard_boxes(f) for f in fps}
    bad = []
    refs = sorted(boxes)
    for i, a in enumerate(refs):
        for b in refs[i + 1:]:
            for ax0, ay0, ax1, ay1 in boxes[a]:
                for bx0, by0, bx1, by1 in boxes[b]:
                    if ax0 < bx1 and bx0 < ax1 and ay0 < by1 and by0 < ay1:
                        ov = min(ax1, bx1) - max(ax0, bx0), min(ay1, by1) - max(ay0, by0)
                        bad.append((a, b, round(pcbnew.ToMM(ov[0]), 2), round(pcbnew.ToMM(ov[1]), 2)))
    return bad


# ---------------------------------------------------------------------------
def build_board():
    board = pcbnew.BOARD()
    board.SetCopperLayerCount(2)
    ds = board.GetDesignSettings()
    nc = ds.m_NetSettings.m_DefaultNetClass
    nc.SetTrackWidth(mm(0.25))
    nc.SetClearance(mm(0.2))
    nc.SetViaDiameter(mm(VIA_D))
    nc.SetViaDrill(mm(VIA_DRILL))
    ds.m_TrackMinWidth = mm(0.15)
    ds.m_MinClearance = mm(0.15)
    ds.m_ViasMinSize = mm(0.5)
    ds.m_MinThroughDrill = mm(0.3)
    ds.m_CopperEdgeClearance = mm(0.3)
    ds.m_HoleClearance = mm(0.25)
    ds.m_HoleToHoleMin = mm(0.25)
    ds.m_SolderMaskExpansion = mm(0.05)
    ds.m_SolderMaskMinWidth = 0
    if VARIANT == 'hand':
        # GND plosky tlacitek u hrany dosahne zona jen jednim mustkem (proud ~uA, druha vrstva taky) - OK
        ds.m_MinResolvedSpokes = 1

    nets = {}
    def net(name):
        if not name:
            return None
        if name not in nets:
            ni = pcbnew.NETINFO_ITEM(board, name)
            board.Add(ni)
            nets[name] = ni
        return nets[name]

    for ref, fpdef, value, x, y, rot, padmap, _jlc in PARTS:
        if fpdef == 'C3ZERO':
            fp = make_c3zero(board)
        elif fpdef == 'TP4056MOD':
            fp = make_tp4056_module(board)
        else:
            fp = load_fp(*fpdef)
        fp.SetReference(ref)
        fp.SetValue(value)
        fp.Reference().SetTextSize(pcbnew.VECTOR2I(mm(0.8), mm(0.8)))
        fp.Reference().SetTextThickness(mm(SILK_W))
        fp.Reference().SetVisible(False)   # popisky jsou vlastni (SILK), refs jsou v BOM/CPL
        fp.Value().SetLayer(pcbnew.F_Fab)
        # rucni varianta: hodnota R/C na F.Fab doprostred soucastky -> osazovaci vykres
        hand_val = VARIANT == 'hand' and ref[0] in 'RC' and ref[1:].isdigit()
        fp.Value().SetVisible(hand_val)
        board.Add(fp)
        fp.SetPosition(pcbnew.VECTOR2I(mm(x), mm(y)))
        fp.SetOrientationDegrees(rot)
        if hand_val:
            fp.Value().SetTextSize(pcbnew.VECTOR2I(mm(0.7), mm(0.7)))
            fp.Value().SetTextThickness(mm(0.12))
            fp.Value().SetPosition(pcbnew.VECTOR2I(mm(x), mm(y)))
            for g in fp.GraphicalItems():           # Fab "${REFERENCE}" schovat, oznaceni je na potisku
                if isinstance(g, pcbnew.FP_TEXT) and g.GetLayer() == pcbnew.F_Fab:
                    g.SetVisible(False)
        for p in fp.Pads():
            n = padmap.get(p.GetNumber())
            ni = net(n)
            if ni is not None:
                p.SetNet(ni)
        if ref == 'J1':
            fp.SetZoneConnection(pcbnew.ZONE_CONNECTION_FULL)  # pevne pripojeni stineni USB-C
            for p in fp.Pads():
                if p.GetNumber() == 'S1':
                    front = pcbnew.ToMM(p.GetDrillSize().y) > 1.5
                    slot_l = 1.7 if front else max(1.2, 2 * USB_SLOT_W)
                    p.SetDrillSize(pcbnew.VECTOR2I(mm(USB_SLOT_W), mm(slot_l)))
                    p.SetSize(pcbnew.VECTOR2I(mm(USB_SLOT_W + 0.4), mm(slot_l + 0.4)))
            fp.SetLocalSolderMaskMargin(mm(0.025))
            for p in fp.Pads():
                if p.GetNumber() in ('B1', 'B4', 'B9', 'B12'):
                    ls = p.GetLayerSet(); ls.RemoveLayer(pcbnew.F_Mask); ls.RemoveLayer(pcbnew.F_Paste); p.SetLayerSet(ls)
        lcsc = LCSC.get(value) if VARIANT == 'jlc' else None
        if lcsc and hasattr(fp, 'SetProperty'):
            fp.SetProperty('LCSC', lcsc)

    add_edge(board)
    for t in SILK:
        add_text(board, *t)
    # 0.45 mm pas podel okraju: zadne cesty ani prokovy (JLC: med >= 0.3 mm od hrany)
    k = 0.45
    for layer in (pcbnew.F_Cu, pcbnew.B_Cu):
        for poly in ([(-1, -1), (W + 1, -1), (W + 1, k), (-1, k)], [(-1, H - k), (W + 1, H - k), (W + 1, H + 1), (-1, H + 1)],
                     [(-1, -1), (k, -1), (k, H + 1), (-1, H + 1)], [(W - k, -1), (W + 1, -1), (W + 1, H + 1), (W - k, H + 1)]):
            add_zone(board, None, layer, poly, rule_area=True)
    # 4 zemnici prokovy u chladici plosky TP4056 (mimo plosku - JLC DFM "tht to smd"),
    # s ploskou spojene cestou 0.5 mm -> teplo do spodni zeme
    u1 = board.FindFootprintByReference('U1')
    c = u1.GetPosition() if u1 else None
    for dx in ((-0.6, 0.6) if u1 else ()):
        for dy in (-2.3, 2.3):
            v = pcbnew.PCB_VIA(board)
            v.SetPosition(pcbnew.VECTOR2I(c.x + mm(dx), c.y + mm(dy)))
            v.SetWidth(mm(VIA_D))
            v.SetDrill(mm(VIA_DRILL))
            v.SetNet(nets['GND'])
            board.Add(v)
            t = pcbnew.PCB_TRACK(board)
            t.SetStart(pcbnew.VECTOR2I(c.x + mm(dx), c.y + mm(dy)))
            t.SetEnd(pcbnew.VECTOR2I(c.x + mm(dx), c.y + mm(1.2 if dy > 0 else -1.2)))
            t.SetWidth(mm(0.5))
            t.SetLayer(pcbnew.F_Cu)
            t.SetNet(nets['GND'])
            board.Add(t)
    # pod modulem ESP nesmi byt na horni strane cesty ani prokovy (zkrat na jeho spodni pady)
    add_zone(board, None, pcbnew.F_Cu,
             [(24.5, 42.0), (39.5, 42.0), (39.5, 64.5), (24.5, 64.5)], rule_area=True)
    a1 = board.FindFootprintByReference('A1')
    if a1:
        # popisky plosek modulu + napis do obrysu modulu
        c = a1.GetPosition()
        for num, x, y, lab, _net in MOD_PADS:
            px, py = pcbnew.ToMM(c.x) + x, pcbnew.ToMM(c.y) + y
            add_text(board, lab, px, py - MOD_PAD_D / 2 - 0.85, 0.8)
        cx, cy = pcbnew.ToMM(c.x), pcbnew.ToMM(c.y)
        add_text(board, 'NABIJECI MODUL', cx, cy - 4.0, 1.0)
        add_text(board, 'TP4056 USB-C', cx, cy - 2.2, 1.0)
        add_text(board, 'na pasku, USB-C dolu', cx + 0.6, cy + 0.2, 0.8)
        add_text(board, '+ strana modulu (IN+ OUT+)', cx - MOD_W / 2 + 1.4, cy + 2.0, 0.8, 90)
    if VARIANT == 'hand':
        auto_ref_labels(board, skip={'U3', 'J2', 'J3', 'J5', 'A1', 'J4', 'H1', 'H2', 'H3', 'H4',
                                     'SW1', 'SW2', 'SW3', 'SW4'})
    return board, nets


def export_dsn(board, path):
    if not pcbnew.ExportSpecctraDSN(board, path):
        sys.exit('Export DSN selhal')
    # sirsi cesty pro napajeni (trida "power")
    s = open(path).read()
    m = re.search(r'\(class kicad_default "" (.*?)\(circuit', s, re.S)
    if m:
        members = m.group(1).split()
        power = [n for n in members if n.strip('"') in POWER_NETS]
        rest = [n for n in members if n not in power]
        old = m.group(0)
        new = '(class kicad_default "" ' + ' '.join(rest) + '\n      (circuit'
        s = s.replace(old, new)
        mv = re.search(r'\(padstack "?(Via\[[^"\s]+)"?', s)
        via_name = mv.group(1) if mv else 'Via[0-1]_%d:%d_um' % (round(VIA_D * 1000), round(VIA_DRILL * 1000))
        cls = ('    (class power ' + ' '.join(power) +
               '\n      (circuit\n        (use_via "' + via_name + '")\n      )\n'
               '      (rule\n        (width 500)\n        (clearance 200)\n        (clearance 300 (type via_smd))\n      )\n    )\n')
        # vloz novou tridu pred konec sekce network
        idx = s.rfind('(class kicad_default')
        end = s.find('\n  )\n  (wiring', idx)
        s = s[:end] + '\n' + cls.rstrip('\n') + s[end:]
    s = s.replace('(clearance 200.1)\n      )\n    )', '(clearance 200.1)\n        (clearance 300 (type via_smd))\n      )\n    )', 1)
    s = s.replace('\n  )\n  (wiring', '\n    (class_class (classes kicad_default power default)\n      (rule (clearance 300 (type via_smd)))\n    )\n  )\n  (wiring', 1)
    open(path, 'w').write(s)


def run_freerouting(jar, dsn, ses, passes=40):
    cmd = ['java', '-jar', jar, '-de', dsn, '-do', ses, '-mp', str(passes)]
    if shutil.which('xvfb-run') and not os.environ.get('DISPLAY'):
        cmd = ['xvfb-run', '-a'] + cmd
    print('>>', ' '.join(cmd))
    subprocess.run(cmd, check=False, timeout=1800, stdout=subprocess.PIPE, stderr=subprocess.STDOUT)
    if not os.path.exists(ses):
        sys.exit('Freerouting nevytvoril SES')


def import_ses(board, nets, ses):
    """Nacte cesty a prokovy ze SES (Specctra session) do desky."""
    s = open(ses).read()
    res = re.search(r'\(resolution\s+(\w+)\s+(\d+)\)', s)
    unit, per = res.group(1), int(res.group(2))
    scale = {'um': 1e-3, 'mm': 1.0, 'mil': 0.0254, 'inch': 25.4}[unit] / per  # -> mm
    layers = {'F.Cu': pcbnew.F_Cu, 'B.Cu': pcbnew.B_Cu}
    count_t = count_v = 0
    existing = {(v.GetPosition().x, v.GetPosition().y) for v in board.GetTracks() if v.GetClass() == 'PCB_VIA'}
    # projdeme bloky (net ...) v sekci network_out
    pos = s.find('(network_out')
    body = s[pos:]
    net_re = re.compile(r'\(net\s+("([^"]*)"|(\S+))')
    for m in net_re.finditer(body):
        name = m.group(2) if m.group(2) is not None else m.group(3)
        start = m.end()
        nxt = net_re.search(body, start)
        block = body[start: nxt.start() if nxt else len(body)]
        ni = nets.get(name)
        if ni is None:
            continue
        for w in re.finditer(r'\(path\s+(\S+)\s+(\d+)\s+([-\d\s]+)\)', block):
            layer = layers.get(w.group(1))
            width = int(w.group(2)) * scale
            nums = list(map(int, w.group(3).split()))
            pts = [(nums[i] * scale, -nums[i + 1] * scale) for i in range(0, len(nums) - 1, 2)]
            for (x1, y1), (x2, y2) in zip(pts, pts[1:]):
                t = pcbnew.PCB_TRACK(board)
                t.SetStart(pcbnew.VECTOR2I(mm(x1), mm(y1)))
                t.SetEnd(pcbnew.VECTOR2I(mm(x2), mm(y2)))
                t.SetWidth(mm(width))
                t.SetLayer(layer)
                t.SetNet(ni)
                board.Add(t)
                count_t += 1
        for v in re.finditer(r'\(via\s+"?([^"\s]+)"?\s+(-?\d+)\s+(-?\d+)', block):
            mv = re.search(r'(\d+):(\d+)_um', v.group(1))
            dia, drill = (int(mv.group(1)) / 1000, int(mv.group(2)) / 1000) if mv else (VIA_D, VIA_DRILL)
            vp = pcbnew.VECTOR2I(mm(int(v.group(2)) * scale), mm(-int(v.group(3)) * scale))
            if any(abs(vp.x - ex) < mm(0.05) and abs(vp.y - ey) < mm(0.05) for ex, ey in existing):
                continue
            via = pcbnew.PCB_VIA(board)
            via.SetPosition(vp)
            via.SetWidth(mm(dia))
            via.SetDrill(mm(drill))
            via.SetNet(ni)
            board.Add(via)
            count_v += 1
    print(f'importovano {count_t} usecek, {count_v} prokovu')


def _silk_holes(board):
    out = []
    for fp in board.GetFootprints():
        for p in fp.Pads():
            if p.GetDrillSize().x <= 0:
                continue
            hs = p.GetEffectiveHoleShape()
            a, b, r = hs.GetSeg().A, hs.GetSeg().B, hs.GetWidth() / 2
            n = max(1, int(math.hypot(b.x - a.x, b.y - a.y) / (r / 4)))
            for k in range(n + 1):
                out.append((a.x + (b.x - a.x) * k / n, a.y + (b.y - a.y) * k / n, r))
    for v in board.GetTracks():
        if v.GetClass() == 'PCB_VIA':
            out.append((v.GetPosition().x, v.GetPosition().y, v.GetDrillValue() / 2))
    return out


def _silk_pad_polys(board, layer, extra):
    """Masky padu (pad + expanze) nafouknute o extra -> seznam (bbox, SHAPE_POLY_SET)."""
    mlayer = pcbnew.F_Mask if layer == pcbnew.F_SilkS else pcbnew.B_Mask
    out = []
    for fp in board.GetFootprints():
        for p in fp.Pads():
            if not p.IsOnLayer(mlayer):
                continue
            ps = pcbnew.SHAPE_POLY_SET()
            p.TransformShapeToPolygon(ps, mlayer, int(p.GetSolderMaskExpansion() + extra), mm(0.005))
            bb = ps.BBox()
            out.append(((bb.GetX(), bb.GetY(), bb.GetRight(), bb.GetBottom()), ps))
    return out


def _cut_intervals(ax, ay, bx, by, holes, extra, pads):
    dx, dy = bx - ax, by - ay
    L2 = dx * dx + dy * dy
    cut = []
    for hx, hy, r in holes:
        R = r + extra
        fx, fy = ax - hx, ay - hy
        A, B, C = L2, 2 * (fx * dx + fy * dy), fx * fx + fy * fy - R * R
        if A == 0:
            continue
        disc = B * B - 4 * A * C
        if disc <= 0:
            continue
        sq = math.sqrt(disc)
        t0, t1 = (-B - sq) / (2 * A), (-B + sq) / (2 * A)
        if t1 <= 0 or t0 >= 1:
            continue
        cut.append((max(0.0, t0), min(1.0, t1)))
    if pads:
        L = math.sqrt(L2)
        n = max(2, int(L / mm(0.01)))
        x0, x1, y0, y1 = min(ax, bx), max(ax, bx), min(ay, by), max(ay, by)
        cand = [ps for (bx0, by0, bx1, by1), ps in pads if bx0 <= x1 and x0 <= bx1 and by0 <= y1 and y0 <= by1]
        if cand:
            inside = [any(ps.Contains(pcbnew.VECTOR2I(int(ax + dx * k / n), int(ay + dy * k / n))) for ps in cand)
                      for k in range(n + 1)]
            k = 0
            while k <= n:
                if inside[k]:
                    j = k
                    while j + 1 <= n and inside[j + 1]:
                        j += 1
                    cut.append((max(0.0, (k - 1) / n), min(1.0, (j + 1) / n)))
                    k = j + 1
                else:
                    k += 1
    keep, t = [], 0.0
    for c0, c1 in sorted(cut):
        if c0 > t:
            keep.append((t, c0))
        t = max(t, c1)
    if t < 1.0:
        keep.append((t, 1.0))
    return keep, bool(cut)


def _clip_rect(ax, ay, bx, by, x0, y0, x1, y1):
    """Liang-Barsky: cast usecky uvnitr obdelniku jako (t0, t1), nebo None."""
    t0, t1 = 0.0, 1.0
    dx, dy = bx - ax, by - ay
    for p, q in ((-dx, ax - x0), (dx, x1 - ax), (-dy, ay - y0), (dy, y1 - ay)):
        if p == 0:
            if q < 0:
                return None
            continue
        r = q / p
        if p < 0:
            t0 = max(t0, r)
        else:
            t1 = min(t1, r)
        if t0 >= t1:
            return None
    return t0, t1


def fix_silk(board):
    """Po routovani: potisk >= SILK_W, cary potisku oriznout u vrtani (a volitelne u masek padu)."""
    silk = (pcbnew.F_SilkS, pcbnew.B_SilkS)
    holes = _silk_holes(board)
    pads = {L: (_silk_pad_polys(board, L, mm(SILK_PAD_CLR + 0.1)) if SILK_PAD_CLR > 0 else []) for L in silk}  # +0.1 = pul sirky cary (<= 0.2)
    pads_bb = {L: (_silk_pad_polys(board, L, mm(SILK_PAD_CLR)) if SILK_PAD_CLR > 0 else []) for L in silk}   # pro znacky: bbox uz obsahuje sirku cary
    n_w = n_cut = n_bad = 0
    for fp in board.GetFootprints():
        for t in (fp.Reference(), fp.Value()):
            if t.GetTextThickness() < mm(SILK_W):
                t.SetTextThickness(mm(SILK_W))
        for g in list(fp.GraphicalItems()):
            if g.GetLayer() not in silk:
                continue
            if isinstance(g, pcbnew.FP_TEXT):
                if g.GetTextThickness() < mm(SILK_W):
                    g.SetTextThickness(mm(SILK_W)); n_w += 1
                continue
            if g.GetWidth() < mm(SILK_W):
                g.SetWidth(mm(SILK_W)); n_w += 1
            if g.GetShape() == pcbnew.SHAPE_T_POLY:
                # vyplnena znacka (napr. pin 1): neorezava se, ale posune se od otvoru/masky padu
                def poly_hits():
                    bb = g.GetBoundingBox()                 # obalovy obdelnik (vc. sirky cary), konzervativne
                    x0, y0, x1, y1 = bb.GetX(), bb.GetY(), bb.GetRight(), bb.GetBottom()
                    lay = pads_bb.get(g.GetLayer(), [])
                    for (ax, ay), (bx, by) in (((x0, y0), (x1, y0)), ((x1, y0), (x1, y1)), ((x1, y1), (x0, y1)), ((x0, y1), (x0, y0))):
                        if _cut_intervals(ax, ay, bx, by, holes, mm(SILK_HOLE_CLR), lay)[1]:
                            return True
                    return False
                if poly_hits():
                    done = False
                    for k in range(1, 13):                  # posun az o 0.6 mm
                        for dx, dy in ((1, 0), (-1, 0), (0, 1), (0, -1), (1, 1), (-1, 1), (1, -1), (-1, -1)):
                            v = pcbnew.VECTOR2I(dx * mm(0.05 * k), dy * mm(0.05 * k))
                            g.Move(v)
                            if not poly_hits():
                                done = True; break
                            g.Move(pcbnew.VECTOR2I(-v.x, -v.y))
                        if done:
                            break
                    if done:
                        g.SetLocalCoord()
                        print(f'  znacka potisku {fp.GetReference()} posunuta o {0.05 * k:.2f} mm')
                    else:
                        g.SetLayer(pcbnew.F_Fab if g.GetLayer() == pcbnew.F_SilkS else pcbnew.B_Fab)
                        print(f'  POZOR: znacka potisku {fp.GetReference()} nejde posunout -> Fab (chybi orientace)')
                        n_bad += 1
                continue
            if g.GetShape() != pcbnew.SHAPE_T_SEGMENT:
                continue
            a, b = g.GetStart(), g.GetEnd()
            ext = g.GetWidth() // 2
            pp = []
            if pads[g.GetLayer()]:
                # nafouknout o polovinu sirky cary navic
                pp = [(bb, ps) for bb, ps in pads[g.GetLayer()]]
            keep, hit = _cut_intervals(a.x, a.y, b.x, b.y, holes, mm(SILK_HOLE_CLR) + ext,
                                       [((bb[0] - ext, bb[1] - ext, bb[2] + ext, bb[3] + ext), ps) for bb, ps in pp] if pp else [])
            e = mm(SILK_EDGE_CLR) + ext
            inside = _clip_rect(a.x, a.y, b.x, b.y, e, e, mm(W) - e, mm(H) - e)
            edge_hit = inside != (0.0, 1.0)
            if edge_hit:
                hit = True
                keep = [(max(t0, inside[0]), min(t1, inside[1])) for t0, t1 in keep
                        if inside and min(t1, inside[1]) > max(t0, inside[0])]
            if not hit:
                continue
            # kratke znacky (napr. katodova carka) nejdriv zkusit odsunout o <= 0.1 mm, teprve pak orezat
            L0 = math.hypot(b.x - a.x, b.y - a.y)
            kept0 = sum((t1 - t0) * L0 for t0, t1 in keep if (t1 - t0) * L0 >= mm(SILK_MIN_SEG))
            if kept0 < 0.5 * L0 and not edge_hit:   # cara u hrany desky se jen orizne
                lay = [((bb[0] - ext, bb[1] - ext, bb[2] + ext, bb[3] + ext), ps) for bb, ps in pp] if pp else []
                done = None
                for k in range(1, 5):
                    for dx, dy in ((1, 0), (-1, 0), (0, 1), (0, -1), (1, 1), (-1, 1), (1, -1), (-1, -1)):
                        ox, oy = dx * mm(0.025 * k), dy * mm(0.025 * k)
                        if not _cut_intervals(a.x + ox, a.y + oy, b.x + ox, b.y + oy, holes, mm(SILK_HOLE_CLR) + ext, lay)[1]:
                            done = (ox, oy); break
                    if done:
                        break
                if done:
                    g.SetStart(pcbnew.VECTOR2I(int(a.x + done[0]), int(a.y + done[1])))
                    g.SetEnd(pcbnew.VECTOR2I(int(b.x + done[0]), int(b.y + done[1])))
                    g.SetLocalCoord()
                    continue
            n_cut += 1
            L = math.hypot(b.x - a.x, b.y - a.y)
            for t0, t1 in keep:
                if (t1 - t0) * L < mm(SILK_MIN_SEG):
                    continue
                s2 = pcbnew.FP_SHAPE(fp)
                s2.SetShape(pcbnew.SHAPE_T_SEGMENT)
                s2.SetLayer(g.GetLayer())
                s2.SetWidth(g.GetWidth())
                fp.Add(s2)
                s2.SetStart(pcbnew.VECTOR2I(int(a.x + (b.x - a.x) * t0), int(a.y + (b.y - a.y) * t0)))
                s2.SetEnd(pcbnew.VECTOR2I(int(a.x + (b.x - a.x) * t1), int(a.y + (b.y - a.y) * t1)))
                s2.SetLocalCoord()
            fp.Remove(g)
    def _text_hits(d):
        shp = d.GetEffectiveTextShape()          # drzet referenci (SWIG)
        lay = pads.get(d.GetLayer(), [])
        for seg in shp.GetSubshapes():
            sa, sb, hw = seg.GetSeg().A, seg.GetSeg().B, seg.GetWidth() // 2
            pp = [((bb[0] - hw, bb[1] - hw, bb[2] + hw, bb[3] + hw), ps) for bb, ps in lay]
            _k, hit = _cut_intervals(sa.x, sa.y, sb.x, sb.y, holes, mm(SILK_HOLE_CLR) + hw, pp)
            if hit:
                return True
        return False
    for d in list(board.GetDrawings()):
        if d.GetLayer() not in silk or not isinstance(d, pcbnew.PCB_TEXT):
            continue
        if d.GetTextThickness() < mm(SILK_W):
            d.SetTextThickness(mm(SILK_W)); n_w += 1
        if not _text_hits(d):
            continue
        p0 = d.GetPosition(); moved = None
        for k in range(1, 11):                      # posun az o 1.0 mm, nejmensi mozny
            for dx, dy in ((0, 1), (0, -1), (1, 0), (-1, 0), (1, 1), (-1, 1), (1, -1), (-1, -1)):
                d.SetPosition(pcbnew.VECTOR2I(p0.x + dx * mm(0.1 * k), p0.y + dy * mm(0.1 * k)))
                if not _text_hits(d):
                    moved = (dx * 0.1 * k, dy * 0.1 * k); break
            if moved:
                break
        if moved:
            print(f'  text "{d.GetText()}" posunut o ({moved[0]:+.1f}, {moved[1]:+.1f}) mm od otvoru/padu')
        else:
            d.SetPosition(p0)
            print(f'  POZOR: text "{d.GetText()}" je blize nez {SILK_HOLE_CLR} mm k otvoru - uprav SILK')
            n_bad += 1
    print(f'potisk: {n_w} prvku zesileno na {SILK_W} mm, {n_cut} car oriznuto')
    return n_bad


def add_zones_only(board, nets):
    poly = [(0, 0), (W, 0), (W, H), (0, H)]
    for layer in (pcbnew.F_Cu, pcbnew.B_Cu):
        add_zone(board, nets['GND'], layer, poly)


def fill_zones(board):
    board.BuildListOfNets()
    board.BuildConnectivity()
    zones = pcbnew.ZONES()
    for z in board.Zones():
        if not z.GetIsRuleArea():
            zones.append(z)
    filler = pcbnew.ZONE_FILLER(board)
    filler.Fill(zones)


def run_drc(board, path):
    pcbnew.WriteDRCReport(board, path, pcbnew.EDA_UNITS_MILLIMETRES, True)
    txt = open(path).read()
    viol = re.search(r'\*\* Found (\d+) DRC violations', txt)
    unconn = re.search(r'\*\* Found (\d+) unconnected pads', txt)
    return int(viol.group(1)) if viol else -1, int(unconn.group(1)) if unconn else -1, txt


def fab_outputs(pcb_path, outdir, board):
    gdir = os.path.join(outdir, 'gerber')
    os.makedirs(gdir, exist_ok=True)
    subprocess.run(['kicad-cli', 'pcb', 'export', 'gerbers', '--output', gdir + '/',
                    '--layers', 'F.Cu,B.Cu,F.Paste,F.SilkS,B.SilkS,F.Mask,B.Mask,Edge.Cuts',
                    '--no-x2', '--subtract-soldermask', pcb_path], check=True)
    subprocess.run(['kicad-cli', 'pcb', 'export', 'drill', '--output', gdir + '/', '--format', 'excellon',
                    '--excellon-separate-th', '--generate-map', '--map-format', 'gerberx2', pcb_path], check=True)
    zpath = os.path.join(outdir, f'{NAME}_gerber_JLCPCB.zip')
    with zipfile.ZipFile(zpath, 'w', zipfile.ZIP_DEFLATED) as z:
        for f in sorted(os.listdir(gdir)):
            if not f.endswith('drl_map.gbr'):
                z.write(os.path.join(gdir, f), f)

    if VARIANT == 'hand':
        hand_outputs(pcb_path, outdir, board)
    # BOM + CPL ve formatu JLCPCB (jen SMD dily, ktere osadi JLC)
    jlc_refs = {p[0] for p in PARTS if p[7]}
    groups = {}
    cpl = []
    for fp in board.GetFootprints():
        ref = fp.GetReference()
        if ref not in jlc_refs:
            continue
        val = fp.GetValue()
        fpname = fp.GetFPID().GetLibItemName().wx_str()
        groups.setdefault((val, fpname), []).append(ref)
        pos = fp.GetPosition()
        cpl.append([ref, f'{pcbnew.ToMM(pos.x):.3f}mm', f'{-pcbnew.ToMM(pos.y):.3f}mm', 'Top',
                    f'{fp.GetOrientationDegrees() % 360:.0f}'])
    if jlc_refs:
        with open(os.path.join(outdir, f'{NAME}_BOM_JLCPCB.csv'), 'w', newline='') as f:
            w = csv.writer(f)
            w.writerow(['Comment', 'Designator', 'Footprint', 'LCSC Part #'])
            for (val, fpname), refs in sorted(groups.items()):
                w.writerow([val, ','.join(sorted(refs, key=lambda r: (r[0], int(re.sub(r'\D', '', r) or 0)))),
                            fpname, LCSC.get(val, '')])
        with open(os.path.join(outdir, f'{NAME}_CPL_JLCPCB.csv'), 'w', newline='') as f:
            w = csv.writer(f)
            w.writerow(['Designator', 'Mid X', 'Mid Y', 'Layer', 'Rotation'])
            w.writerows(sorted(cpl))

        # rucne pajene dily (THT) - seznam pro nakup
        with open(os.path.join(outdir, f'{NAME}_rucni_osazeni.csv'), 'w', newline='') as f:
            w = csv.writer(f)
            w.writerow(['Oznaceni', 'Dil', 'Pouzdro'])
            for ref, fpdef, value, *_rest in PARTS:
                if not _rest[-1] and not ref.startswith('H'):
                    w.writerow([ref, value, fpdef if isinstance(fpdef, str) else fpdef[1]])

    # nahledy desky
    for side, layers in (('top', 'F.Cu,F.SilkS,F.Mask,Edge.Cuts'), ('bottom', 'B.Cu,B.SilkS,B.Mask,Edge.Cuts')):
        subprocess.run(['kicad-cli', 'pcb', 'export', 'svg', '--output', os.path.join(outdir, f'{NAME}_{side}.svg'),
                        '--layers', layers, '--exclude-drawing-sheet', '--page-size-mode', '2'] +
                       (['--mirror'] if side == 'bottom' else []) + [pcb_path], check=False)
    subprocess.run(['kicad-cli', 'pcb', 'export', 'step', '--output', os.path.join(outdir, f'{NAME}.step'),
                    '--subst-models', '--force', pcb_path], check=False,
                   stdout=subprocess.DEVNULL, stderr=subprocess.DEVNULL)


def _refkey(r):
    return (re.sub(r'\d', '', r), int(re.sub(r'\D', '', r) or 0))


def hand_outputs(pcb_path, outdir, board):
    """Rucni varianta: seznam soucastek k nakupu + osazovaci vykres (hodnoty u soucastek)."""
    groups = {}
    for ref, fpdef, value, *_rest in PARTS:
        if ref.startswith('H'):
            continue
        pkg = {'C3ZERO': 'modul na listach', 'TP4056MOD': 'hotovy modul'}.get(fpdef) if isinstance(fpdef, str) else fpdef[1]
        pkg = re.sub(r'_\d+Metric.*|_HandSolder.*|_Handsoldering|_TabPin2', '', pkg)
        pkg = re.sub(r'^SolderJumper.*', 'pajeci mustek na desce', pkg)
        groups.setdefault((BOM_VALUE_HAND.get(value, value), pkg), []).append(ref)
    with open(os.path.join(outdir, f'{NAME}_soucastky.csv'), 'w', newline='') as f:
        w = csv.writer(f)
        w.writerow(['Hodnota', 'Pouzdro', 'Kusu', 'Oznaceni na desce', 'Kde koupit / poznamka'])
        order = lambda kv: (kv[1][0][0] not in 'RCDQU', sorted(kv[1], key=_refkey)[0][0], kv[0][0])
        for (val, pkg), refs in sorted(groups.items(), key=order):
            w.writerow([val, pkg, len(refs), ' '.join(sorted(refs, key=_refkey)), SHOP_HAND.get(val, '')])
    # osazovaci vykres: obrysy soucastek, plosky, oznaceni + hodnoty (cernobile, na tisk)
    svg = os.path.join(outdir, f'{NAME}_osazovaci_vykres.svg')
    subprocess.run(['kicad-cli', 'pcb', 'export', 'svg', '--output', svg, '--black-and-white',
                    '--layers', 'F.Fab,F.SilkS,Edge.Cuts', '--exclude-drawing-sheet', '--page-size-mode', '2',
                    pcb_path], check=False, stdout=subprocess.DEVNULL, stderr=subprocess.DEVNULL)
    try:
        import cairosvg
        cairosvg.svg2png(url=svg, write_to=svg[:-4] + '.png', output_width=1100, background_color='white')
    except Exception as e:                      # PNG je jen pro pohodli
        print('  (PNG osazovaciho vykresu nevznikl:', e, ')')


def main():
    ap = argparse.ArgumentParser()
    ap.add_argument('--freerouting', default=os.environ.get('FREEROUTING_JAR', 'freerouting-1.9.0.jar'))
    ap.add_argument('--passes', type=int, default=40)
    ap.add_argument('--place-only', action='store_true')
    ap.add_argument('--reuse-ses', action='store_true', help='nepoustet Freerouting, pouzit build/*.ses')
    ap.add_argument('--force', action='store_true', help='vyrobni data i pri chybach DRC / neroutovanych spojich')
    ap.add_argument('--variant', choices=['jlc', 'hand'], default='jlc',
                    help='jlc = osazeni SMD u JLCPCB (0603); hand = holy spoj, vse pajis sam (1206 + modul TP4056)')
    args = ap.parse_args()

    global PARTS, SILK, NAME, VARIANT
    VARIANT = args.variant
    if VARIANT == 'hand':
        PARTS, SILK, NAME = PARTS_HAND, SILK_HAND, NAME_HAND
    out = os.path.join(HERE, 'build' if VARIANT == 'jlc' else 'build_rucni')
    os.makedirs(out, exist_ok=True)
    board, nets = build_board()
    bad = check_overlaps(board)
    if bad:
        print('PREKRYVY courtyard:')
        for b in bad:
            print('  ', b)
        if not args.force and not args.place_only:
            sys.exit('STOP: soucastky se prekryvaji - uprav pozice v PARTS (nebo --force)')
    pcb_path = os.path.join(HERE, f'{NAME}.kicad_pcb')
    if args.place_only:
        board.Save(pcb_path)
        return

    dsn = os.path.join(out, f'{NAME}.dsn')
    ses = os.path.join(out, f'{NAME}.ses')
    export_dsn(board, dsn)
    if not args.reuse_ses:
        if os.path.exists(ses):
            os.remove(ses)
        run_freerouting(args.freerouting, dsn, ses, args.passes)
    import_ses(board, nets, ses)
    silk_bad = fix_silk(board) + len(REF_MISSING)
    add_zones_only(board, nets)
    board.Save(pcb_path)
    # zony se spolehlive vyleji jen na desce nactene ze souboru (s projektem)
    board = pcbnew.LoadBoard(pcb_path)
    fill_zones(board)
    board.Save(pcb_path)

    nviol, nunc, txt = run_drc(board, os.path.join(out, 'drc.rpt'))
    cats = re.findall(r'^\[(\w+)\]', txt, re.M)
    real = [c for c in cats if c != 'lib_footprint_issues']   # jen chybejici tabulka knihoven
    print(f'DRC: {len(real)} poruseni ({", ".join(sorted(set(real))) or "zadna"}), {nunc} nepripojenych padu ({os.path.basename(out)}/drc.rpt)')
    # nedoroutovana deska nebo potisk na otvoru se nesmi dostat do ZIPu pro vyrobu
    if (nunc != 0 or real or silk_bad) and not args.force:
        for f in (f'{NAME}_gerber_JLCPCB.zip', f'{NAME}_BOM_JLCPCB.csv', f'{NAME}_CPL_JLCPCB.csv',
                  f'{NAME}_rucni_osazeni.csv', f'{NAME}.step', f'{NAME}_soucastky.csv',
                  f'{NAME}_osazovaci_vykres.svg', f'{NAME}_osazovaci_vykres.png'):
            if os.path.exists(os.path.join(out, f)):
                os.remove(os.path.join(out, f))      # stara data by k nove desce nesedela
        sys.exit('STOP: deska neni cista (DRC / nepripojene pady / potisk) - vyrobni data NEvytvorena. '
                 'Zkus vic --passes, uprav rozmisteni, nebo --force.')
    fab_outputs(pcb_path, out, board)
    print('Hotovo ->', out)


if __name__ == '__main__':
    main()
