Alwwex/Cyklopo-ta-/(commit log)

2026-07-19 Add ESP32 CykloComp firmware and React Native companion app
    Full smart bike computer system: NimBLE-based ESP32-C3 firmware
    (ST7789 display, GPS filtering, 4 screens incl. vector map with
    overview/tracking modes, button handling, NVS persistence) paired
    with an Android app (BLE sync with MTU/reconnect handling, route
    planning via BRouter/OSRM, OSM street fetching via Overpass,
    gamification, ride history).
    Claude-Session: https://claude.ai/code/session_01VD8kCsSUePQwdMgfUxX15f
2026-07-20 Add USB-serial debug channel and fix display text ghosting
    Firmware now mirrors the BLE text protocol over native USB-CDC
    (handleCommand shared between both), so the device can be driven
    from a PC without the Android app during this phase. Added
    tools/usb_console.py for interactive testing and route upload.
    Also fixes leftover glyph fragments on the TFT: drawField() now
    clears the union of the old and new text's actual bounding boxes
    (via getTextBounds) instead of a fixed-size rect, and text wrap is
    disabled so long strings can't spill into neighboring panels.
    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
    [CykloComp.ino]
2026-10-08 Firmware v2: DS/Game Boy style dashboard, themes, battery, sleep, ride log sync, BLE sensors
    - 7-segment speed digits + colour arc gauge with avg/max markers, 2x2 tiles
    - three themes (NOC dark, RETRO Game Boy green, DEN high-contrast)
    - board profiles (breadboard / CykloPCB v1): battery ADC, backlight PWM,
    GPS power switch, deep sleep with wake button, auto power-off
    - auto-pause, ascent, grade, GPS glitch filtering, phone time sync
    - rides stored in LittleFS and downloadable via SYNC:* (bulk characteristic)
    - optional BLE heart-rate and cadence sensors in a separate FreeRTOS task
    - BLE commands queued and processed in loop (no races with drawing)
    - GPS simulation (SIM:1) for bench testin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
    [CykloComp.ino, preview.cpp]
2026-10-08 Add CykloComp web app (PWA, Web Bluetooth) with demo mode
    - dashboard with speed arc + DSEG7 digits mirroring the device themes
    - Leaflet map: live track, BRouter planning with elevation, GPX import,
    sending route + OSM streets to the device
    - ride history synced from the device (SYNC protocol), GPX export
    - gamification profile, device + app settings, backup/restore
    - offline-capable service worker, installable manifest, icons
    - GitHub Pages deploy workflow
    Claude-Session: https://claude.ai/code/session_01U4G6Wqkxv8dALXYEZtDemh
2026-10-08 Add CykloPCB v1: generated KiCad carrier board with JLCPCB outputs
    - TP4056 charger with load-sharing power path, slide switch, AP2112K LDO
    - battery divider to GPIO0, P-MOSFET switches for GPS power and backlight
    - side buttons (MODE wakes from deep sleep) + header for external buttons
    - footprint for Waveshare ESP32-C3-Zero with pin labels
    - generate_pcb.py: placement -> Freerouting -> GND pours -> DRC ->
    Gerber/drill zip, BOM + CPL for JLCPCB assembly, STEP, previews
    - schematic diagram (schemdraw) and ordering/bring-up guide
    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
    [CykloPCB_v1.kicad_pcb, CykloPCB_v1.step, CykloPCB_v1_BOM_JLCPCB.csv, CykloPCB_v1_rucni_osazeni.csv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]
2026-10-08 Add parametric 3D printed enclosure with Garmin quarter-turn cleat
    - OpenSCAD model derived from CykloPCB v1 geometry (ports, buttons, switch)
    - lid with display window, protective sheet recess and glass pocket
    - battery tray clamped with the PCB, GPS antenna platform under the lid
    - separate Garmin cleat + quick test piece, STL exports and renders
    - firmware: TFT_ROTATION option for flipped display mounting
    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
    [base.stl, cleat.stl, cyklocomp_case.scad, garmin_test.stl, lid.stl, tray.stl]
2026-10-08 Docs: new README, shopping list, recommendations (app, display, charger)
    - README rewritten: overview, quick start, firmware v2 controls/screens,
    full BLE protocol incl. status/bulk characteristics and SYNC, USB testing
    - docs/NAKUP.md: what to order (PCB at JLCPCB, parts, enclosure, upgrades)
    - docs/DOPORUCENI.md: PWA vs native, display options, charging (TP4056 issues,
    power-path, safety diode for the breadboard setup)
    - notes in app/ and tools/usb_console.py for the new features
    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
2026-10-09 PCB: fix JLCPCB DFM findings (slots, vias, EP vias, silkscreen, mask)
    - USB-C shield slots 0.6 -> 0.7 mm (slot width check)
    - vias 0.6/0.3 -> 0.7/0.3, 0.2 mm annular ring
    - TP4056 exposed-pad GND vias moved out of the pad, tied with 0.5 mm stubs
    - Freerouting keeps vias >= 0.3 mm from SMD pads; LED column moved to x=18.5
    - silkscreen >= 0.16 mm, clipped >= 0.25 mm from holes and 0.2 mm from
    pad openings and board edge; pin-1 marks and texts nudged clear
    - solder mask +0.05 mm (USB-C +0.025), no stacked openings on USB-C pads
    - generator refuses to write fab outputs for a dirty board (--force)
    Claude-Session: https://claude.ai/code/se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
    [CykloPCB_v1.kicad_pcb, CykloPCB_v1.step, cyklocomp_case.scad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]
2026-10-09 PCB: silk pass keeps U2 pin-1 mark, trims off-board silk; docs fixes
    - edge-trimmed silk no longer goes through the nudge branch (a J1 line
    outside the board was being kept)
    - pin-1 marks checked at 0.2 mm from pad openings (was 0.3), moved up to
    0.6 mm; an unmovable mark now stops the fab export
    - stale fab outputs are removed when the export is refused
    - README: correct edge-clearance and LED-move wording
    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
    [CykloPCB_v1.kicad_pcb, CykloPCB_v1.step, cyklocomp_case.scad]
2026-10-09 PCB: refresh preview renders
    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
2026-10-10 PCB: green status LED D2 -> LCSC C7429914 (NationStar NCD0603G3)
    C72043 ran out of stock at JLC (1 pc). NCD0603G3 is a 0603 emerald-green
    LED with pad 1 = cathode, same footprint and CPL rotation.
    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
    [CykloPCB_v1.kicad_pcb, CykloPCB_v1.step, CykloPCB_v1_BOM_JLCPCB.csv]
2026-10-10 PCB generator: add hand-solder variant scaffolding (--variant hand)
    - separate parts list for a bare board: 1206 HandSolder passives, SOT-23
    hand-solder FETs, SOT-223 LDO, SMA diode, wire pads for an off-the-shelf
    TP4056 USB-C module instead of on-board USB-C + TP4056
    - reference labels on silk, assembly drawing with values, parts list CSV
    - courtyard overlaps now stop the fab export
    - render_preview.py and the enclosure (pcb_variant) understand the variant;
    the JLC board and enclosure outputs are unchanged
    Placement of the hand variant is still work in progress.
    Claude-Session: https://claude.ai/code/session_01U4G6Wqkxv8dALXYEZ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
    [cyklocomp_case.scad]
2026-10-10 Hand-solder variant: module wiring with B- pad, J4/JP1, shop notes, enclosure
    - TP4056 module wire pads in one row beyond the module: IN+, OUT+, B-, OUT-;
    battery JST J4 minus goes to B- (behind the module's protection),
    JP1 bridges B- to GND for modules without protection
    - 19 x 30.5 mm keep-out covers the common 25-28.4 mm USB-C modules
    - parts list gets Czech shop notes (MCP1825S SOT-223 LDO, SK34A SMA, ...)
    - enclosure pcb_variant="rucni": taller USB-C opening for the raised
    module, LED window in the left wall, SW1 opening follows sw1_y
    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
    [cyklocomp_case.scad]
2026-10-15 Hand-solder board CykloPCB v1 R: placed, routed, DRC clean
    - bare-board variant for hand soldering: 1206 passives, SOT-23 hand-solder
    FETs, MCP1825S SOT-223 LDO, SMA Schottky, the user's TP4056 USB-C module
    taped on and wired to an IN+/OUT+/B-/OUT- pad row
    - routed with Freerouting: 0 DRC violations, 0 unconnected; gerbers
    measured: vias 0.7/0.3 (ring 0.2), silk 0.16 mm >= 0.25 mm from holes
    and >= 0.2 mm from pads, no stacked mask openings
    - reference labels on silk, black-and-white assembly drawing with values,
    parts list with Czech shop notes
    - module courtyard is L-shaped (closed outline), overlap check understands it
    - enclosure: base_rucni.stl / tray_rucni.stl (raised USB-C o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
2026-10-15 Hand board review fixes: firmware USB detect, silk, assembly drawing, enclosure
    Firmware:
    - USB power detection with hysteresis (on > 4.30 V, off < 4.25 V); the
    module charges at ~1 A, so VBUS behind the Schottky can sit near 4.4 V
    - low-battery shutdown only between 3.0 and 3.35 V, so powering just the
    ESP from its own USB (3.3 V back-feed) no longer triggers it
    Hand board:
    - thermal reliefs on SMD GND pads (easier with a hobby iron)
    - 'ON' at the pin-1 end of SW1, 'K' at the D3 cathode, C5 label placement
    - assembly drawing: values centred on R/C bodies, refs from silk, no copper
    Enclosure:
    - tray notch over J5 (a 1x4 header no longer hits the tray)
    - wider rounded-rectangle opening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
